GeraciGregory/HypnosiaController/Documentation/Report/HYPNOSIA_Controller_Summary.pdf

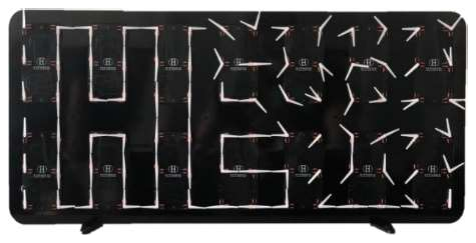
[picture p11: figure]
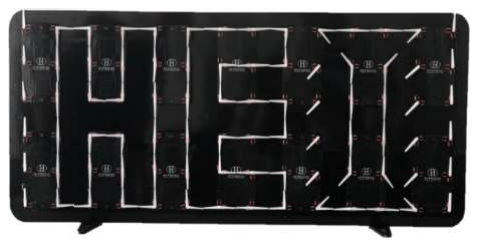
[picture p12: figure]

| 2 0 2 0 |

Degree programme
Industrial Systems

Field of application
Infotronics

Supervising professor
Dr Silvan Zahno
silvan.zahno@hevs.ch

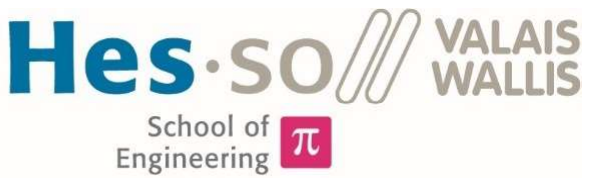
[picture p13: figure]

## Objectives

The project consists in developing and implementing a prototype of a bi-axes movements matrix display that allows the creation of the most hypnotizing animations.

## Methods | Experiences | Results

The matrix display consists of 84 bi-axes movements produced by SOPROD SA. The ultimate goal is to control animations via Bluetooth according to the user's wishes.

The system is composed of a MASTER (Raspberry Pi), a GATEWAY (processor) and 13 SLAVES (processor). The system works as follows: the Raspberry Pi (MASTER) manages the Bluetooth connection and transmits the data required to control the movement matrix to the processor (GATEWAY) via SPI. This processor then processes the data received via SPI and transmits the data to all other processors (SLAVES) via a CAN bus. Each processor controls 6 bi-axes movements.

The first prototype developed gives conclusive results.

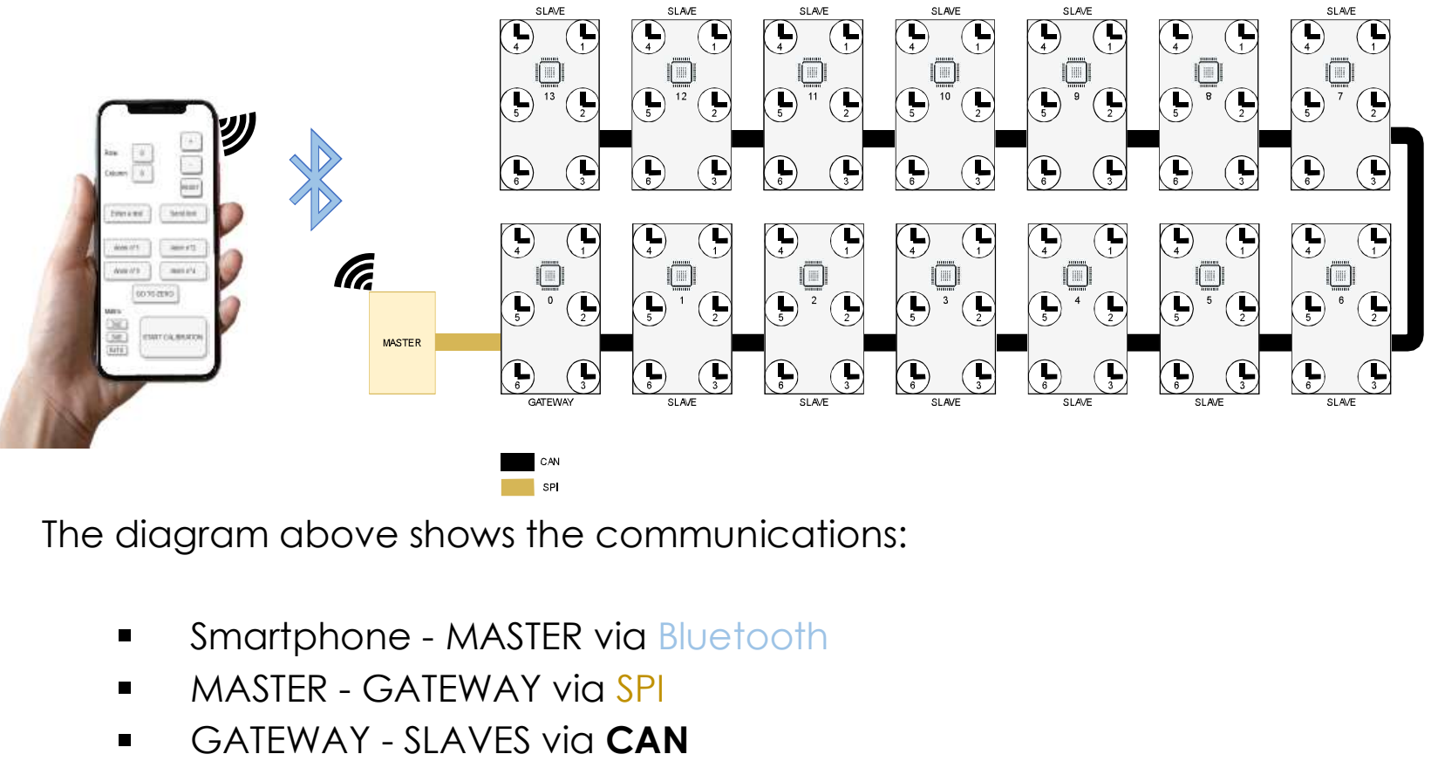
[picture p14: figure]
Smartphone - MASTER via Bluetooth MASTER - GATEWAY via SPI GATEWAY - SLAVES via CAN

The diagram above shows the communications:

# HYPNOSIA Controller

Graduate | Gregory Geraci
