GeraciGregory/HypnosiaController/HYPNOSIA_Altium/HYPNOSIA_V1_CAN/hypnosia_top_v1_180620.PNG

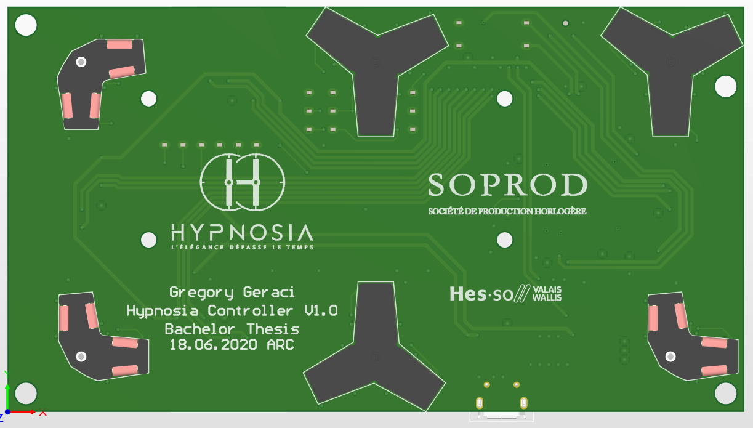
HYPNOSIA_Altium/HYPNOSIA_V1_CAN/hypnosia_top_v1_180620.PNG
