GeraciGregory/HypnosiaController/Documentation/HYPNOSIA_Prices_Chart.xlsx

Prices
Material | Price / 1 unit | Price / 10 units | Price / 100 units | Price / 1000 units | Price / 5000 units | Manufacturer | Currency
Movment | 7 | 6 | 5 | 4 | 3 | SOPROD SA | CHF
Raspberry Pi Zero | 20 | 19 | 18 | 17 | 15 | / | CHF
Microcontroller ARM STM32F072V8T6 | 3.82 | 3.24 | 2.81 | 2.01 | 1.88 | Mouser | CHF
Molex 5 pin SMD male | 2.61 | 2.36 | 2.06 | 1.37 | 1.27 | Mouser | CHF
Molex 5 pin SMD female | 0.458 | 0.358 | 0.31 | 0.248 | 0.2 | Mouser | CHF
MICRO USB B Connector | 0.706 | 0.537 | 0.47 | 0.369 | 0.3 | Mouser | CHF
LDO voltage converter | 0.82 | 0.7 | 0.474 | 0.349 | 0.33 | Mouser | CHF
CAN converter MCP2542 | 0.735 | 0.611 | 0.563 | 0.48 | 0.41 | Mouser | CHF
Pin Header 2x20 SMD | 4.05 | 3.88 | 3.24 | 2.34 | 2.11 | Mouser | CHF
Quartz 16MHz | 0.515 | 0.429 | 0.343 | 0.275 | 0.248 | Mouser | CHF
PCB 2x3 (58mm x 106mm) | 19.8 | 10.5 | 2.04 | 0.945 | 0.764 | PCBWay | US $
PCB 3x8 (106mm x 346mm) | 29.4 | 18.2 | 7.01 | 4.56 | 4.522 | PCBWay | US $
PCB 6x14 (250mm x 634mm) | 87.6 | 60.8 | 31.01 | 28.811 | 28.63 | PCBWay | US $
Box | 30 | 25 | 20 | 10 | 7 | / | CHF
Watch pointers | 0.5 | 0.45 | 0.3 | 0.15 | 0.05 | / | CHF
3x8 model with 2x3 PCB |  |  |  |  |  |  |  |  | 6x14 model with 2x3 PCB
Need | Quantity for one model | Price / 1 unit | Price / 10 unit | Price / 100 unit | Price / 1000 unit | Price / 5000 unit |  |  | Need | Quantity for one model | Price / 1 unit | Price / 10 unit | Price / 100 unit | Price / 1000 unit | Price / 5000 unit
Movment | 24 | 168 | 144 | 120 | 96 | 72 |  |  | Movment | 88 | 616 | 528 | 440 | 352 | 264
Raspberry Pi Zero | 1 | 20 | 19 | 18 | 17 | 15 |  |  | Raspberry Pi Zero | 1 | 20 | 19 | 18 | 17 | 15
Microcontroller ARM STM32F072V8T6 | 4 | 15.28 | 12.96 | 11.24 | 8.04 | 7.52 |  |  | Microcontroller ARM STM32F072V8T6 | 14 | 53.48 | 45.36 | 39.34 | 28.14 | 26.32
Molex 5 pin SMD male | 6 | 15.66 | 14.16 | 12.36 | 8.22 | 7.62 |  |  | Molex 5 pin SMD male | 26 | 67.86 | 61.36 | 53.56 | 35.62 | 33.02
Molex 5 pin SMD female | 6 | 2.748 | 2.148 | 1.86 | 1.488 | 1.2 |  |  | Molex 5 pin SMD female | 26 | 11.908 | 9.308 | 8.06 | 6.448 | 5.2
CAN converter MCP2542 | 4 | 2.94 | 2.444 | 2.252 | 1.92 | 1.64 |  |  | CAN converter MCP2542 | 14 | 10.29 | 8.554 | 7.882 | 6.72 | 5.74
Pin Header 2x20 SMD | 1 | 4.05 | 3.88 | 3.24 | 2.34 | 2.11 |  |  | Pin Header 2x20 SMD | 1 | 4.05 | 3.88 | 3.24 | 2.34 | 2.11
Quartz 16MHz | 4 | 2.06 | 1.716 | 1.372 | 1.1 | 0.992 |  |  | Quartz 16MHz | 14 | 7.21 | 6.006 | 4.802 | 3.85 | 3.472
Box | 1 | 30 | 25 | 20 | 10 | 7 |  |  | Box | 1 | 30 | 25 | 20 | 10 | 7
Watch pointers | 48 | 24 | 21.6 | 14.4 | 7.2 | 2.4 |  |  | Watch pointers | 168 | 84 | 75.6 | 50.4 | 25.2 | 8.4
PCB 2x3 | 4 | 79.2 | 42 | 8.16 | 3.78 | 3.056 |  |  | PCB 2x3 | 14 | 277.2 | 147 | 28.56 | 13.23 | 10.696
 | Total | 363.938 | 288.908 | 212.884 | 157.088 | 120.538 |  |  |  | Total | 1181.998 | 929.068 | 673.844 | 500.548 | 380.958
3x8 model with 3x8 PCB |  |  |  |  |  |  |  |  | 6x14 model with 6x14 PCB
Need | Quantity for one model | Price / 1 unit | Price / 10 unit | Price / 100 unit | Price / 1000 unit | Price / 5000 unit |  |  | Need | Quantity for one model | Price / 1 unit | Price / 10 unit | Price / 100 unit | Price / 1000 unit | Price / 5000 unit
Movment | 24 | 168 | 144 | 120 | 96 | 72 |  |  | Movment | 88 | 616 | 528 | 440 | 352 | 264
Raspberry Pi Zero | 1 | 20 | 19 | 18 | 17 | 15 |  |  | Raspberry Pi Zero | 1 | 20 | 19 | 18 | 17 | 15
Microcontroller ARM STM32F072V8T6 | 4 | 15.28 | 12.96 | 11.24 | 8.04 | 7.52 |  |  | Microcontroller ARM STM32F072V8T6 | 14 | 53.48 | 45.36 | 39.34 | 28.14 | 26.32
CAN converter MCP2542 | 4 | 2.94 | 2.444 | 2.252 | 1.92 | 1.64 |  |  | CAN converter MCP2542 | 14 | 10.29 | 8.554 | 7.882 | 6.72 | 5.74
Pin Header 2x20 SMD | 1 | 4.05 | 3.88 | 3.24 | 2.34 | 2.11 |  |  | Pin Header 2x20 SMD | 1 | 4.05 | 3.88 | 3.24 | 2.34 | 2.11
Quartz 16MHz | 4 | 2.06 | 1.716 | 1.372 | 1.1 | 0.992 |  |  | Quartz 16MHz | 14 | 7.21 | 6.006 | 4.802 | 3.85 | 3.472
Box | 1 | 30 | 25 | 20 | 10 | 7 |  |  | Box | 1 | 30 | 25 | 20 | 10 | 7
Watch pointers | 48 | 24 | 21.6 | 14.4 | 7.2 | 2.4 |  |  | Watch pointers | 168 | 84 | 75.6 | 50.4 | 25.2 | 8.4
PCB 3x8 | 1 | 29.4 | 18.2 | 7.01 | 4.56 | 4.522 |  |  | PCB 6x14 | 1 | 29.4 | 18.2 | 7.01 | 4.56 | 4.522
 | Total | 295.73 | 248.8 | 197.514 | 148.16 | 113.184 |  |  |  | Total | 854.43 | 729.6 | 590.674 | 449.81 | 336.564
Savec money for all products cost [CHF] |  | 68.208 | 401.08 | 1537 | 8928 | 36770 |  |  | Savec money for all products cost [CHF] |  | 327.568 | 1994.68 | 8317 | 50738 | 221970
 |  |  |  |  |  |  |  | 1
 |  |  |  |  |  |  |  | 10
 |  |  |  |  |  |  |  | 100
 |  |  |  |  |  |  |  | 1000
 |  |  |  |  |  |  |  | 5000
