GeraciGregory/HypnosiaController/HYPNOSIA_Inventor/front_Box.dxf

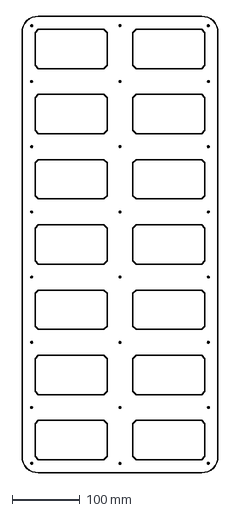
[picture p17: CAD file, 2020-07-16]
HYPNOSIA_Inventor/front_Box.dxf
288.0 x 672.0 mm
