GeraciGregory/HypnosiaController/HYPNOSIA_Inventor/back_Box.dxf

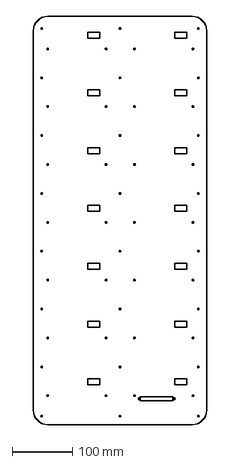
[picture p18: CAD file, 2020-07-16]
HYPNOSIA_Inventor/back_Box.dxf
288.0 x 678.0 mm
