GeraciGregory/HypnosiaController/HYPNOSIA_Inventor/HYPNOSIA_controller_V2.step

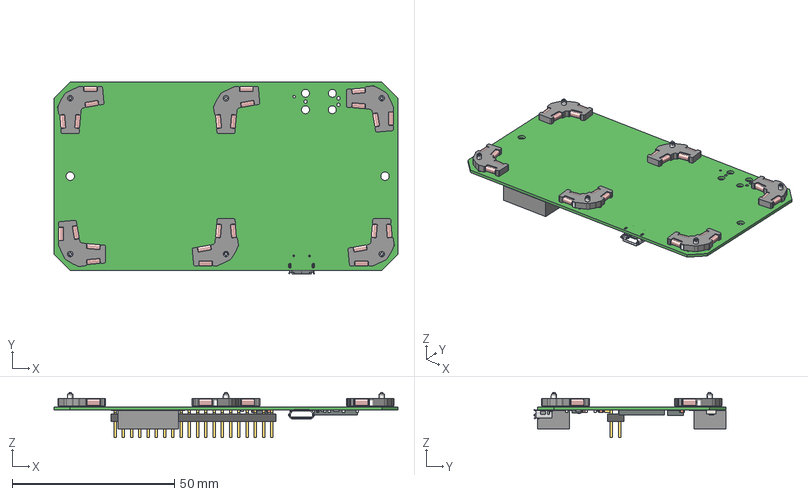
[picture p19: CAD file, 2020-07-08]
HYPNOSIA_Inventor/HYPNOSIA_controller_V2.step
106.0 x 59.2 x 13.9 mm
GB2M x 6
Extruded x 156
User_Library-RESC1608X05N x 2
ZX62D-B-5PA8
Pins x 2
