GeraciGregory/HypnosiaController/(list of files, cad)

Other CAD files:
HYPNOSIA_Inventor/HYPNOSIA_6x14.iam
HYPNOSIA_Inventor/OldVersions/HYPNOSIA_6x14.0009.iam
HYPNOSIA_Inventor/OldVersions/back_Box.0016.ipt
HYPNOSIA_Inventor/OldVersions/front_Box.0012.ipt
HYPNOSIA_Inventor/OldVersions/support.0007.ipt
HYPNOSIA_Inventor/back_Box.ipt
HYPNOSIA_Inventor/front_Box.ipt
HYPNOSIA_Inventor/support.ipt
