GeraciGregory/HypnosiaController/(threads)

Thread 1 (2020-05-29):

v1.0 Schematic Questions/Remarks

tschinz, 2020-05-29:
1. No i2C on STM32 Proc
2. Add notes for resistor placement
3. Properly naming of Pins for the watches
4. Select led and calulate current and resistor
5. Does boot pin need to be exposed?
6. Where goes the TSW0 Signal
7. No external Oscillator needed?
8. Set DNF (Do not Fit) on optional Resistors
9. Powerdelivery only by RPI Header? Can it deliver enough power?
10. Needs optional external Powersupply in case RPI is not mounted (USB Power connector with [5V to 3.3V LDO](https://ch.farnell.com/w/c/halbleiter-ics/power-management-ics-pmic-/spannungsregler/ldo-spannungsregler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)

Closed 2020-06-21.
