GeraciGregory/HypnosiaController/Documentation/Altium/HYPNOSIA_controller_V2.pdf

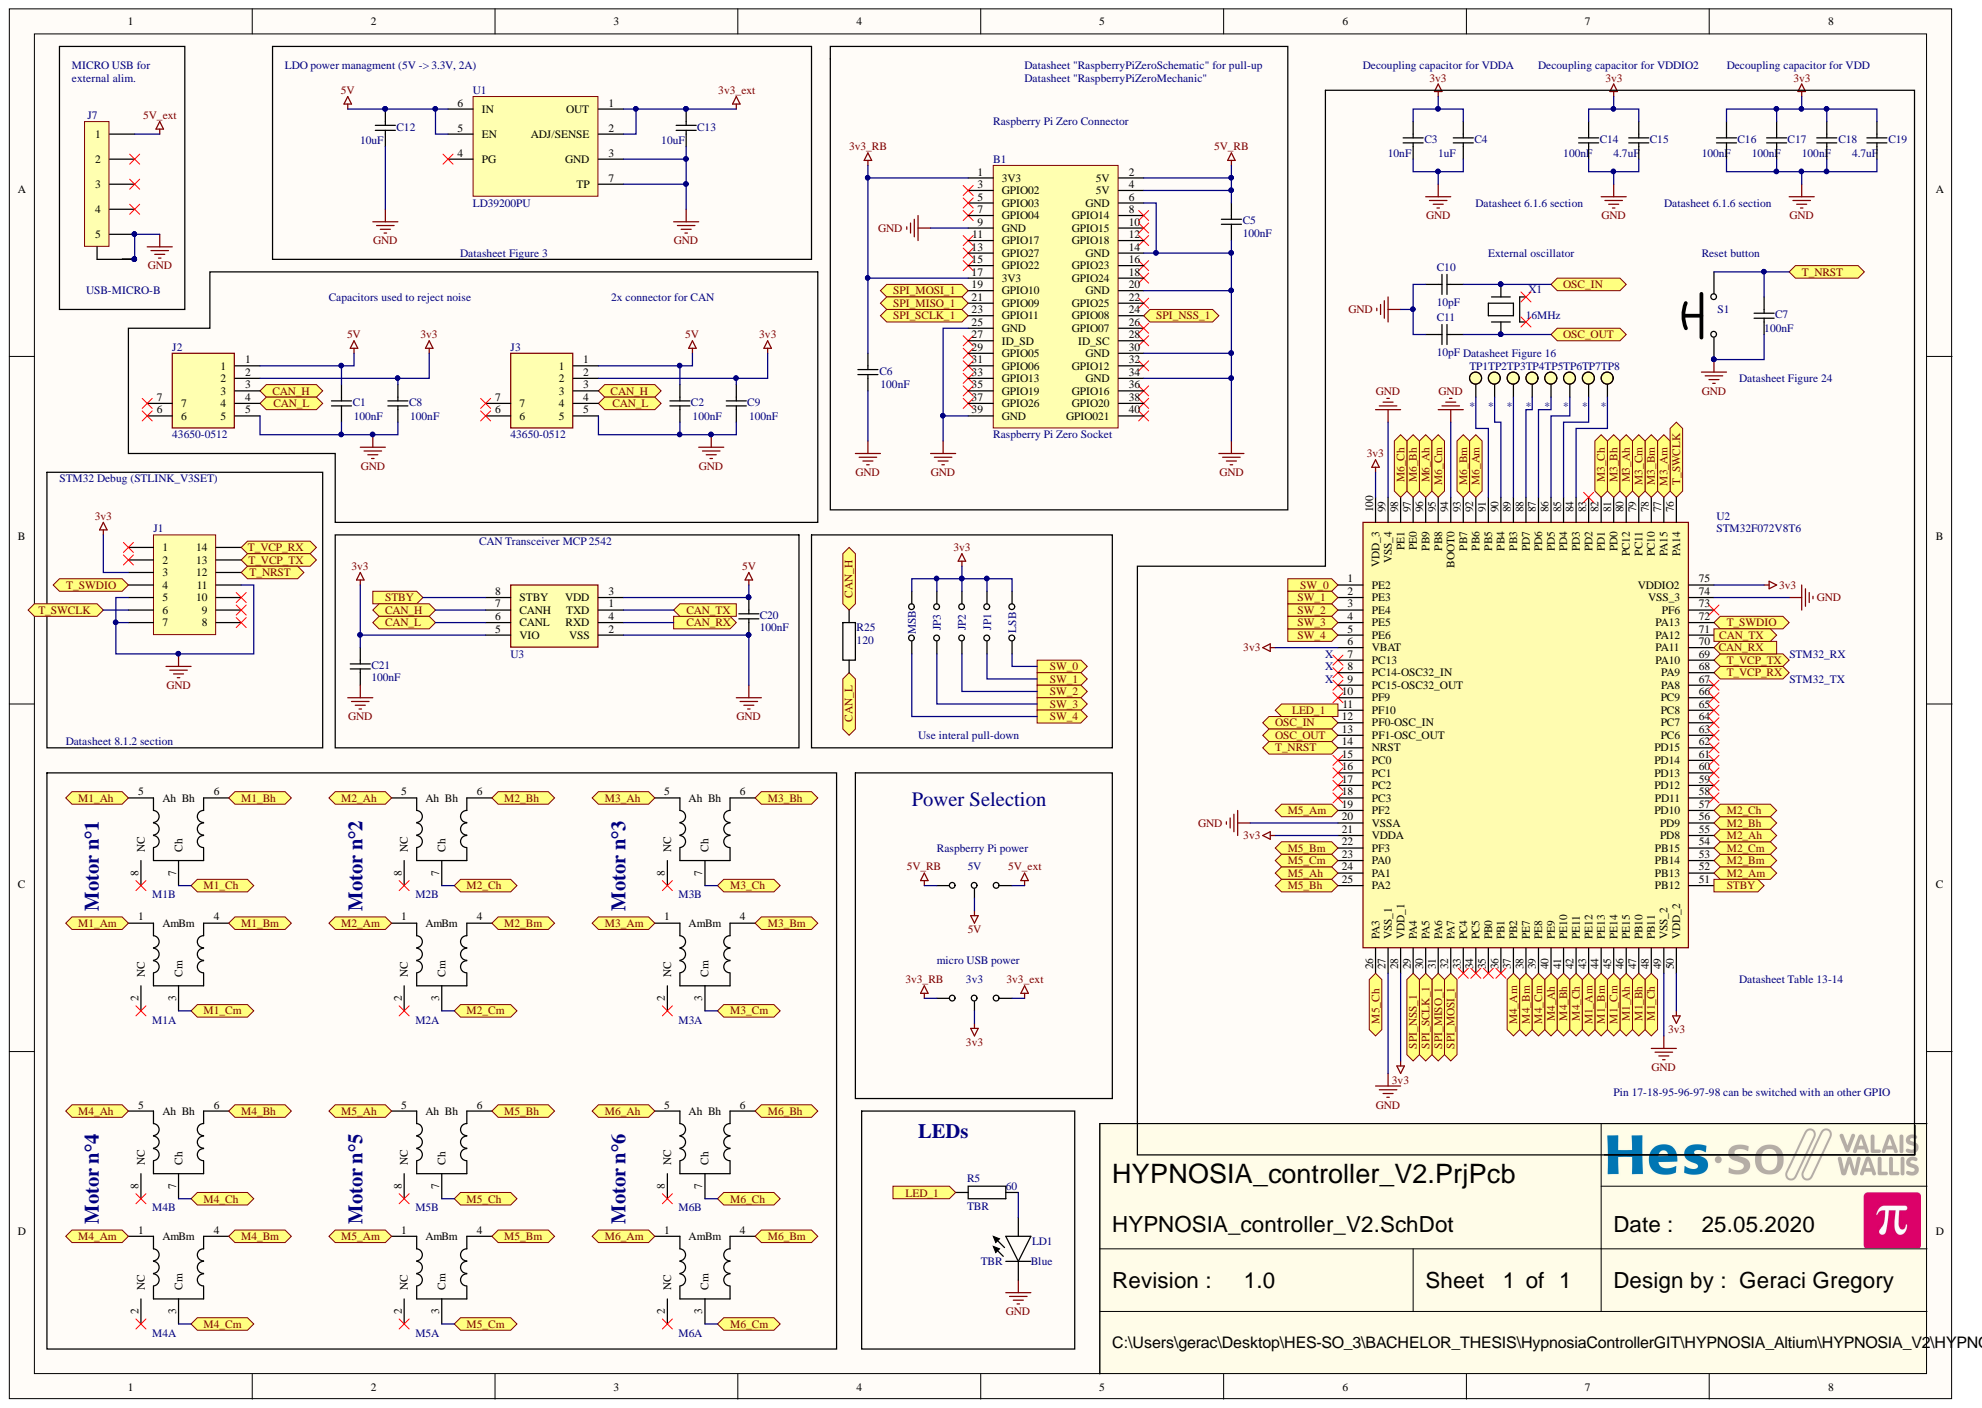
[picture p20: page 1]

Datasheet "RaspberryPiZeroSchematic" for pull-up
Datasheet "RaspberryPiZeroMechanic"

Decoupling capacitor for VDD

Raspberry Pi Zero Connector

Capacitors used to reject noise

Raspberry Pi Zero Socket

Use interal pull-down

Pin 17-18-95-96-97-98 can be switched with an other GPIO

C:\Users\gerac\Desktop\HES-SO_3\BACHELOR_THESIS\HypnosiaControllerGIT\HYPNOSIA_Altium\HYPNOSIA_V2\HYPNOSIA_V2\HYPNOSIA_controller_V2.SchDot

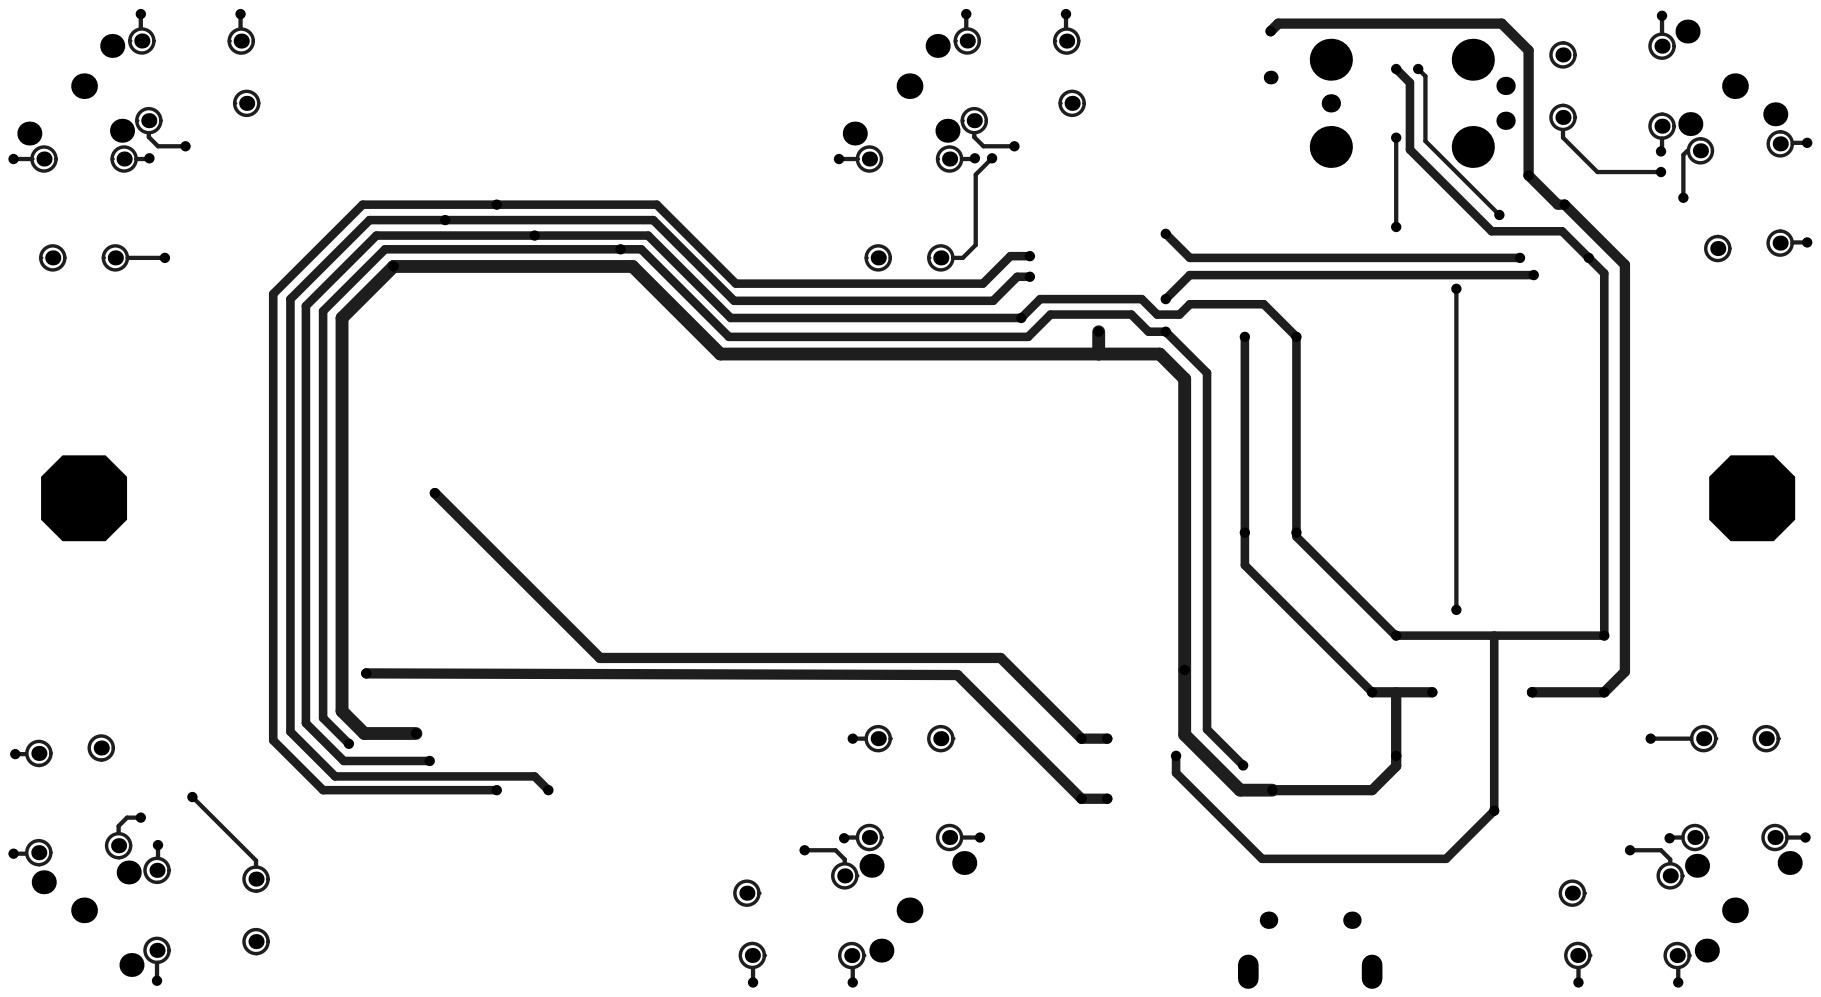
[picture p21: page 2]

# Board Stack Report
