GeraciGregory/HypnosiaController/Documentation/Altium/HYPNOSIA_controller_V1_CAN.pdf

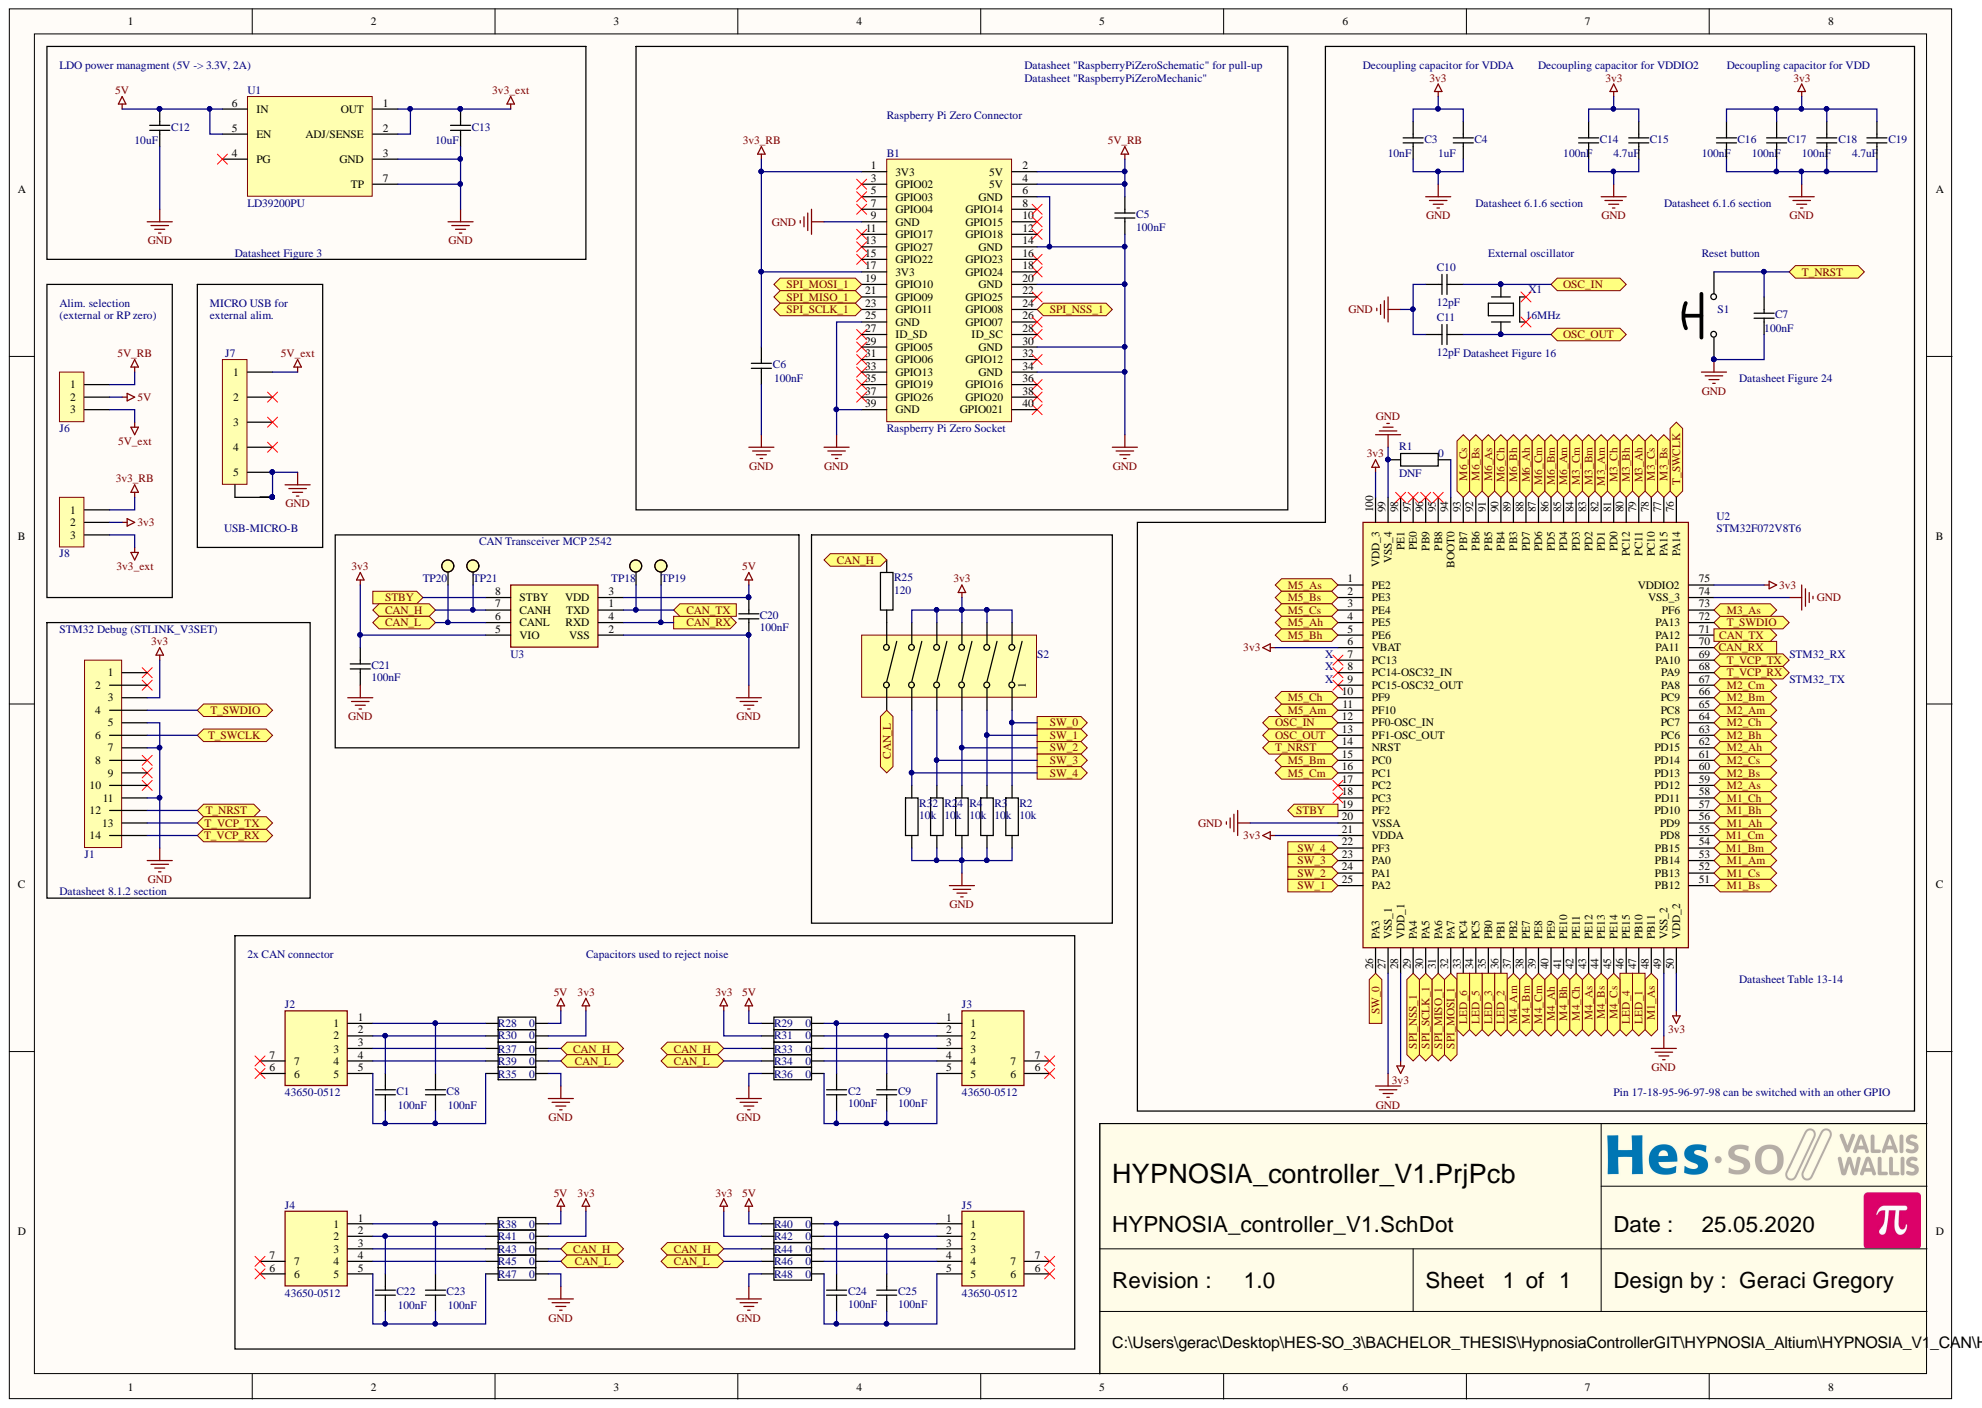
[picture p22: page 1]

Datasheet "RaspberryPiZeroSchematic" for pull-up
Datasheet "RaspberryPiZeroMechanic"

Decoupling capacitor for VDD

Raspberry Pi Zero Connector

Alim. selection
(external or RP zero)

Raspberry Pi Zero Socket

Capacitors used to reject noise

Pin 17-18-95-96-97-98 can be switched with an other GPIO

HYPNOSIA_controller_V1.PrjPcb HYPNOSIA_controller_V1.SchDot

C:\Users\gerac\Desktop\HES-SO_3\BACHELOR_THESIS\HypnosiaControllerGIT\HYPNOSIA_Altium\HYPNOSIA_V1_CAN\HYPNOSIA_controller_V1.SchDot

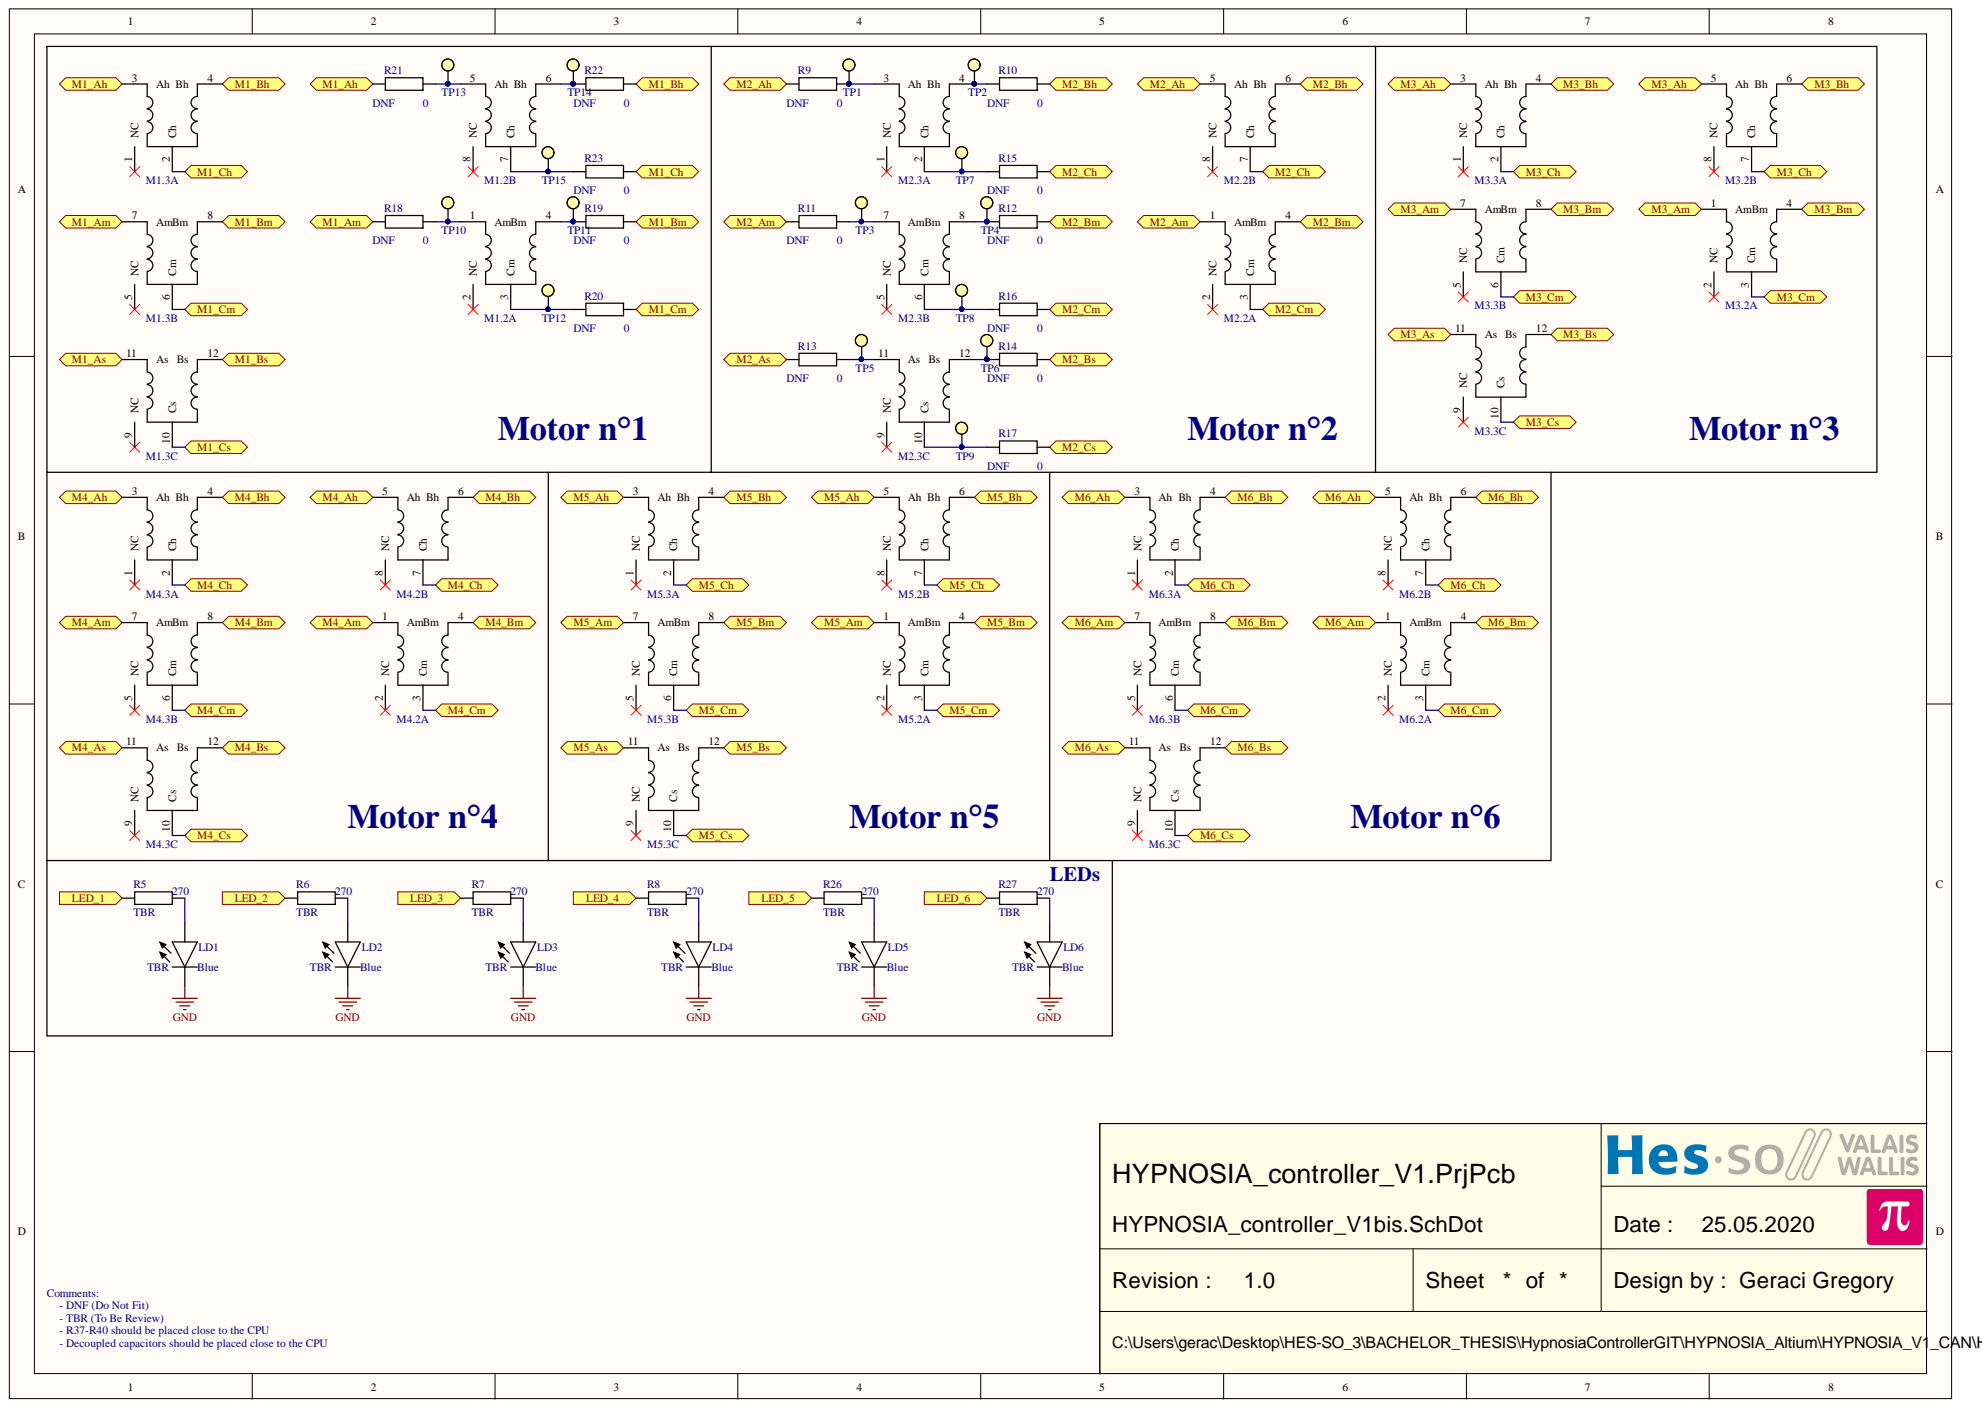
[picture p23: page 2]

HYPNOSIA_controller_V1.PrjPcb HYPNOSIA_controller_V1bis.SchDot

Revision : 1.0 | Sheet * of * | Design by : Geraci Gregory

Comments:
- DNF (Do Not Fit)
- TBR (To Be Review)
- R37-R40 should be placed close to the CPU
- Decoupled capacitors should be placed close to the CPU

C:\Users\gerac\Desktop\HES-SO_3\BACHELOR_THESIS\HypnosiaControllerGIT\HYPNOSIA_Altium\HYPNOSIA_V1_CAN\HYPNOSIA_controller_V1bis.SchDot

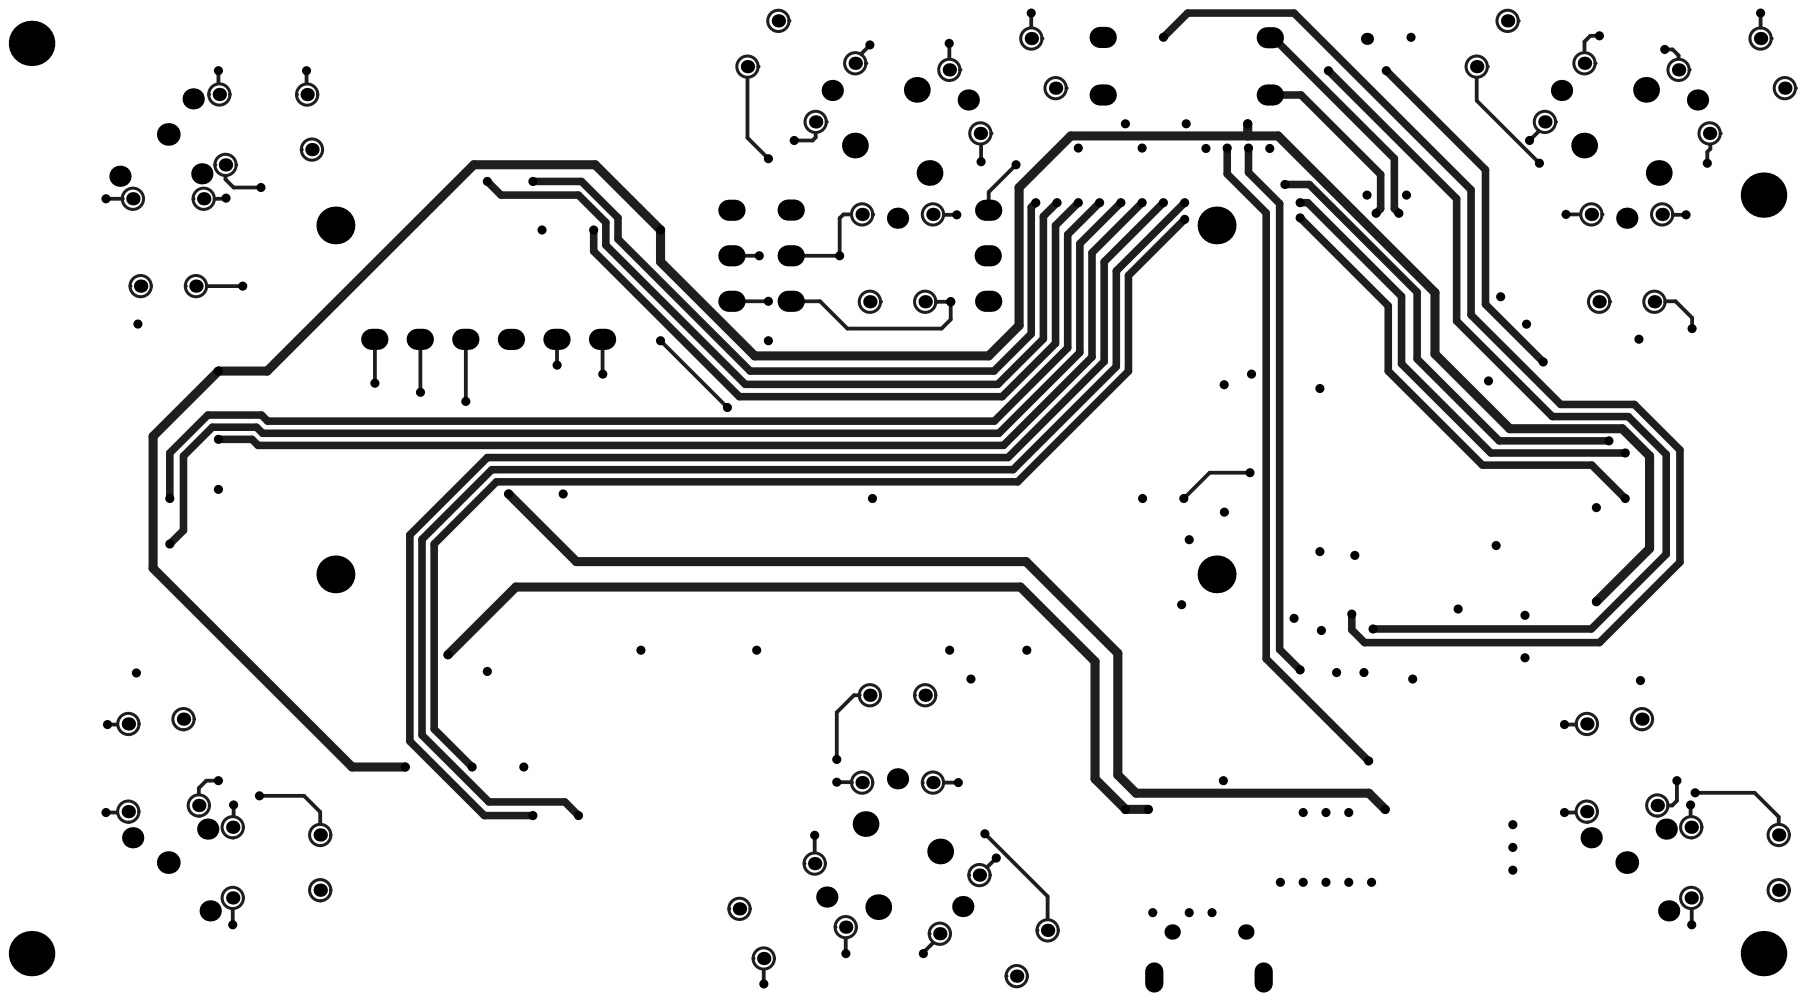
[picture p24: page 3]

# Board Stack Report
