GeraciGregory/HypnosiaController/Documentation/Diagrams/RPI_diagrams.pdf

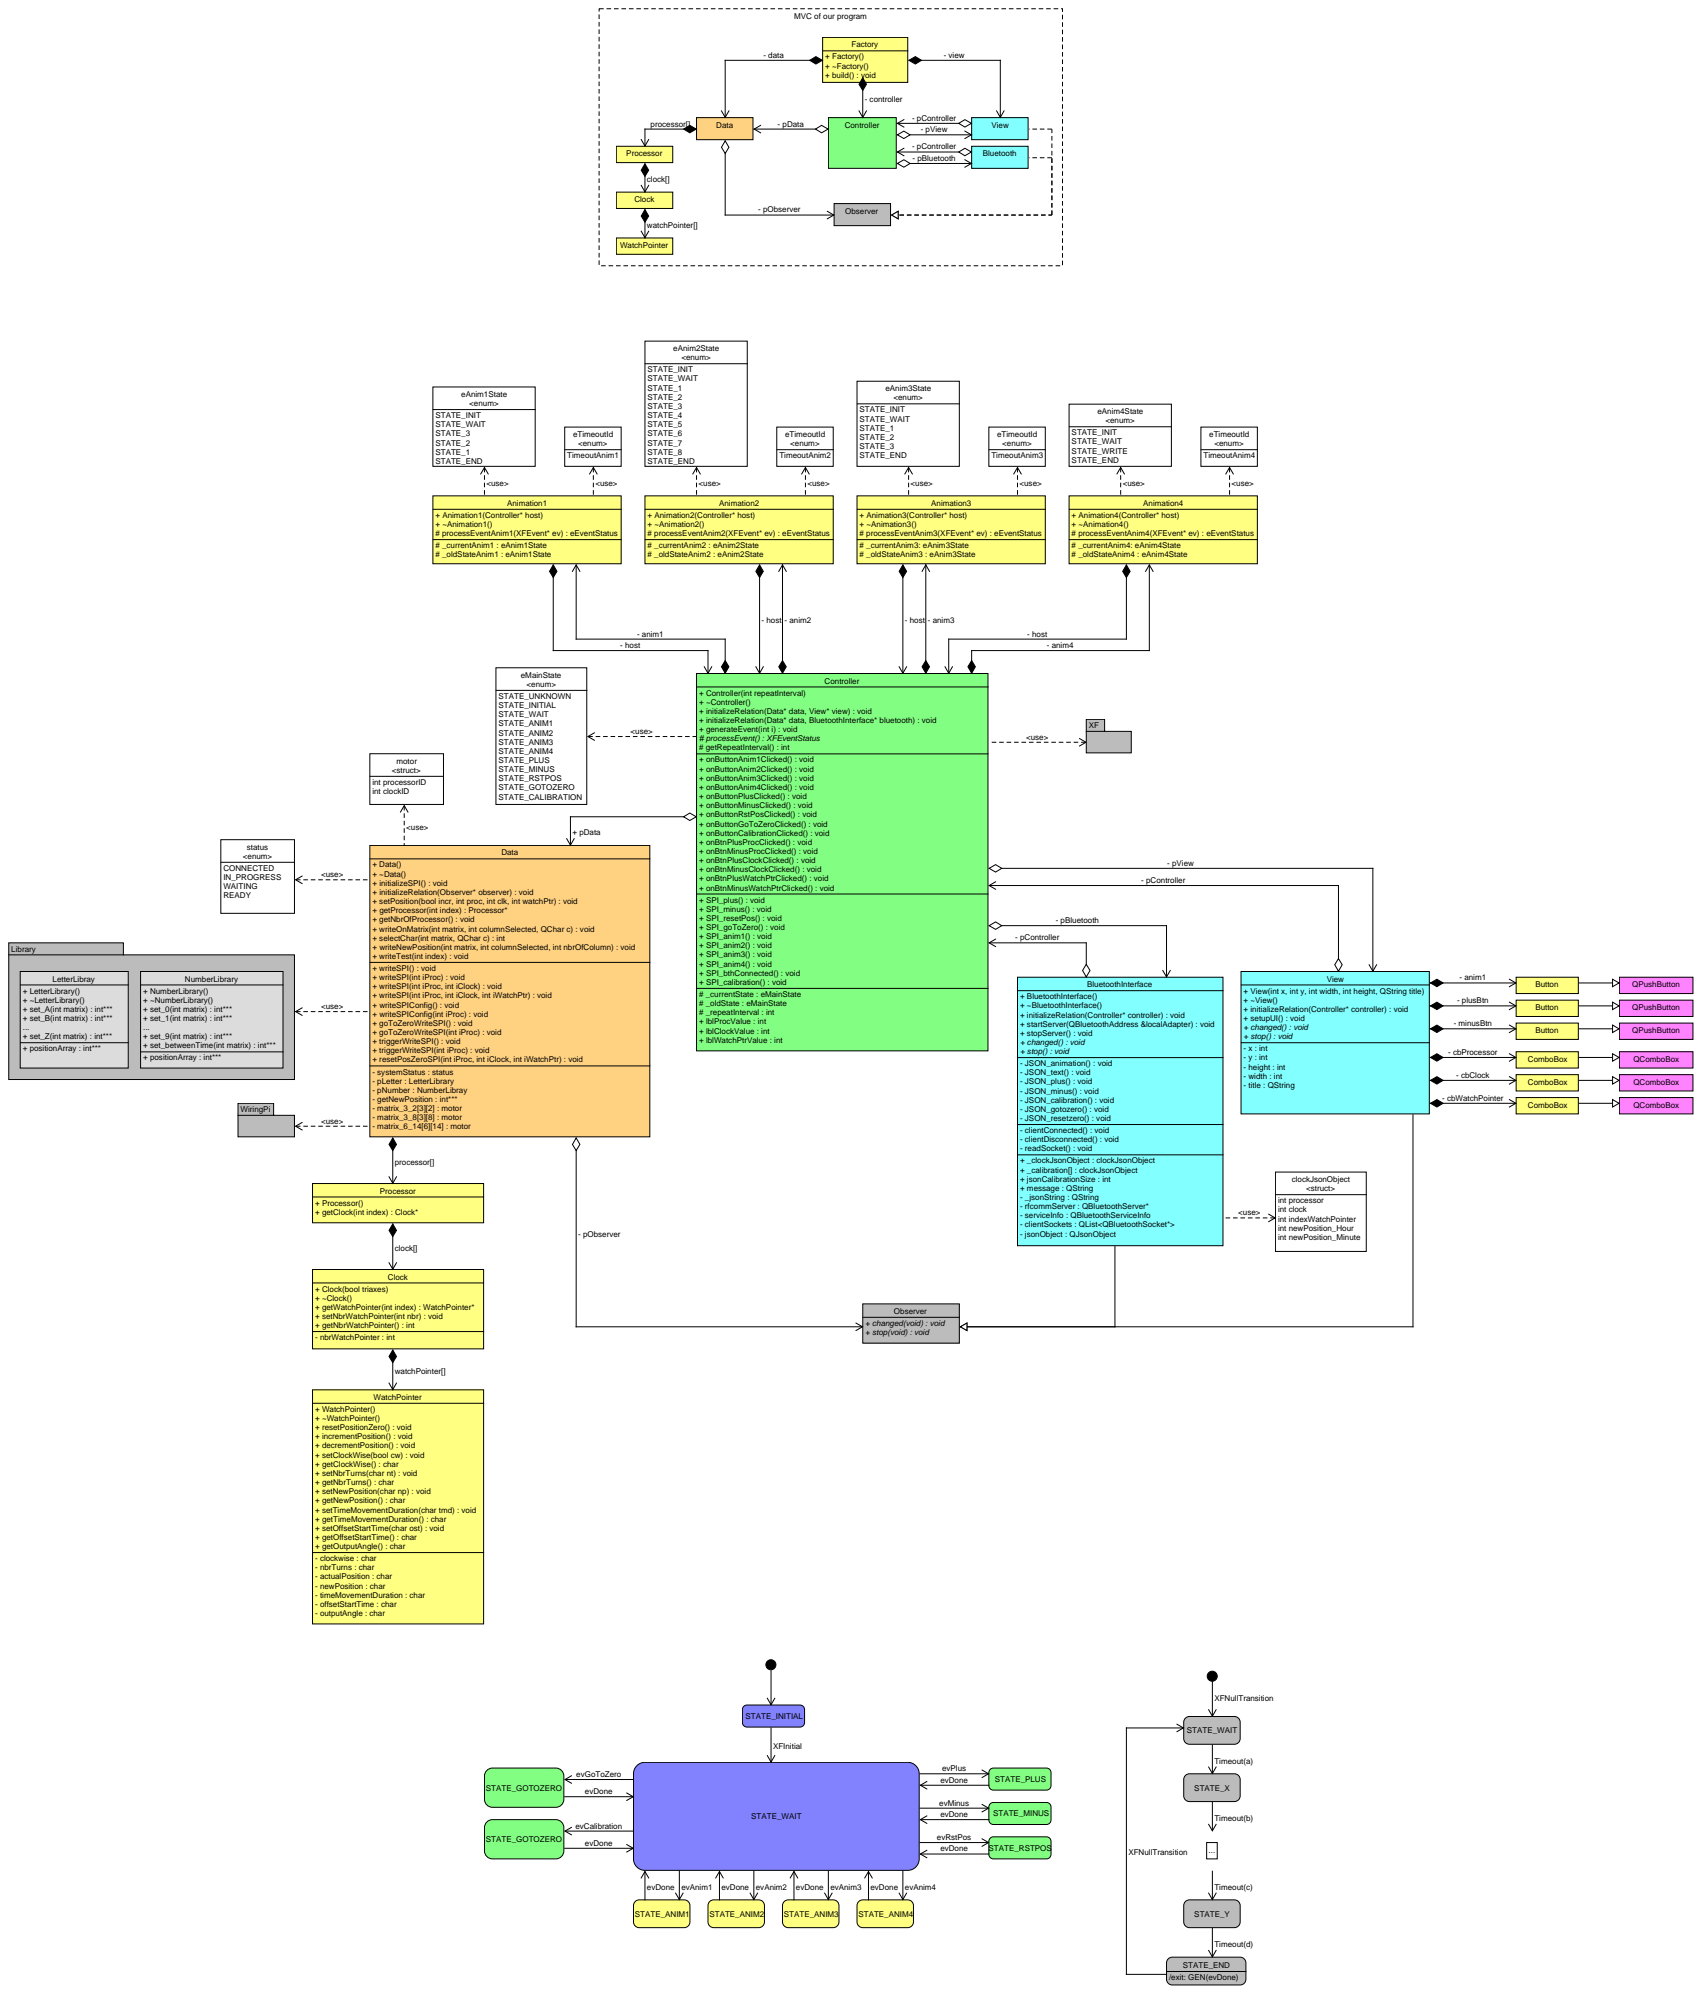
[picture p25: page 1]
Library; STATE_Y; STATE_X; STATE_WAIT; NumberLibrary; LetterLibray; WiringPi; motor <struct> int processorID int clockID; eTimeoutId <enum> TimeoutAnim4; eAnim4State <enum> STATE_INIT STATE_WAIT STATE_WRITE STATE_END; Animation4 + Animation4(Controller* host) + ~Animation4() # processEventAnim4(XFEvent* ev) : eEventStatus # _currentAnim4: eAnim4State # _oldStateAnim4 : eAnim4State; eTimeoutId <enum> TimeoutAnim3; eAnim3State <enum> STATE_INIT STATE_WAIT STATE_1 STATE_2 STATE_3 STATE_END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

MVC of our program

+ Controller(int repeatInterval)
+ ~Controller()
+ initializeRelation(Data* data, View* view) : void
+ initializeRelation(Data* data, BluetoothInterface* bluetooth) : void
+ generateEvent(int i) : void
# processEvent() : XFEventStatus
# getRepeatInterval() : int
+ onButtonAnim1Clicked() : void
+ onButtonAnim2Clicked() : void
+ onButtonAnim3Clicked() : void
+ onButtonAnim4Clicked() : void
+ onButtonPlusClicked() : void
+ onButtonMinusClicked() : void
+ onButtonRstPosClicked() : void
+ onButtonGoToZeroClicked() : void
+ onButtonCalibrationClicked() : void
+ onBtnPlusProcClicked() : void
+ onBtnMinusProcClicked() : void
+ onBtnPlusClockClicked() : void
+ onBtnMinusClockClicked() : void
+ onBtnPlusWatchPtrClicked() : void
+ onBtnMinusWatchPtrClicked() : void
+ SPI_plus() : void
+ SPI_minus() : void
+ SPI_resetPos() : void
+ SPI_goToZero() : void
+ SPI_anim1() : void
+ SPI_anim2() : void
+ SPI_anim3() : void
+ SPI_anim4() : void
+ SPI_bthConnected() : void
+ SPI_calibration() : void
# _currentState : eMainState
# _oldState : eMainState
# _repeatInterval : int
+ lblProcValue : int
+ lblClockValue : int
+ lblWatchPtrValue : int

+ Data()
+ ~Data()
+ initializeSPI() : void
+ initializeRelation(Observer* observer) : void
+ setPosition(bool incr, int proc, int clk, int watchPtr) : void
+ getProcessor(int index) : Processor*
+ getNbrOfProcessor() : void
+ writeOnMatrix(int matrix, int columnSelected, QChar c) : void
+ selectChar(int matrix, QChar c) : int
+ writeNewPosition(int matrix, int columnSelected, int nbrOfColumn) : void
+ writeTest(int index) : void
+ writeSPI() : void
+ writeSPI(int iProc) : void
+ writeSPI(int iProc, int iClock) : void
+ writeSPI(int iProc, int iClock, int iWatchPtr) : void
+ writeSPIConfig() : void
+ writeSPIConfig(int iProc) : void
+ goToZeroWriteSPI() : void
+ goToZeroWriteSPI(int iProc) : void
+ triggerWriteSPI() : void
+ triggerWriteSPI(int iProc) : void
+ resetPosZeroSPI(int iProc, int iClock, int iWatchPtr) : void
- systemStatus : status
- pLetter : LetterLibrary
- pNumber : NumberLibray
- getNewPosition : int***
- matrix_3_2[3][2] : motor
- matrix_3_8[3][8] : motor
- matrix_6_14[6][14] : motor

+ LetterLibrary()
+ ~LetterLibrary()
+ set_A(int matrix) : int***
+ set_B(int matrix) : int***
+ set_Z(int matrix) : int***
+ positionArray : int***

+ NumberLibrary()
+ ~NumberLibrary()
+ set_0(int matrix) : int***
+ set_1(int matrix) : int***
+ set_9(int matrix) : int***
+ set_betweenTime(int matrix) : int***

+ View(int x, int y, int width, int height, QString title)
+ ~View()
+ initializeRelation(Controller* controller) : void
+ setupUI() : void
+ changed() : void
+ stop() : void
- x : int
- y : int
- height : int
- width : int
- title : QString

+ BluetoothInterface()
+ ~BluetoothInterface()
+ startServer(QBluetoothAddress &localAdapter) : void
+ stopServer() : void
- JSON_animation() : void
- JSON_text() : void
- JSON_plus() : void
- JSON_minus() : void
- JSON_calibration() : void
- JSON_gotozero() : void
- JSON_resetzero() : void
- clientConnected() : void
- clientDisconnected() : void
- readSocket() : void
+ _clockJsonObject : clockJsonObject
+ _calibration[] : clockJsonObject
+ jsonCalibrationSize : int
+ message : QString
- _jsonString : QString
- rfcommServer : QBluetoothServer*
- serviceInfo : QBluetoothServiceInfo
- clientSockets : QList<QBluetoothSocket*>
- jsonObject : QJsonObject

+ Processor()
+ getClock(int index) : Clock*

+ Clock(bool triaxes)
+ ~Clock()
+ getWatchPointer(int index) : WatchPointer*
+ setNbrWatchPointer(int nbr) : void
+ getNbrWatchPointer() : int
- nbrWatchPointer : int

+ changed(void) : void
+ stop(void) : void

+ WatchPointer()
+ ~WatchPointer()
+ resetPositionZero() : void
+ incrementPosition() : void
+ decrementPosition() : void
+ setClockWise(bool cw) : void
+ getClockWise() : char
+ setNbrTurns(char nt) : void
+ getNbrTurns() : char
+ setNewPosition(char np) : void
+ getNewPosition() : char
+ setTimeMovementDuration(char tmd) : void
+ getTimeMovementDuration() : char
+ setOffsetStartTime(char ost) : void
+ getOffsetStartTime() : char
+ getOutputAngle() : char
- clockwise : char
- nbrTurns : char
- actualPosition : char
- newPosition : char
- timeMovementDuration : char
- offsetStartTime : char
- outputAngle : char

STATE_END
/exit: GEN(evDone)
