GeraciGregory/HypnosiaController/Documentation/Diagrams/STM32_diagrams.pdf

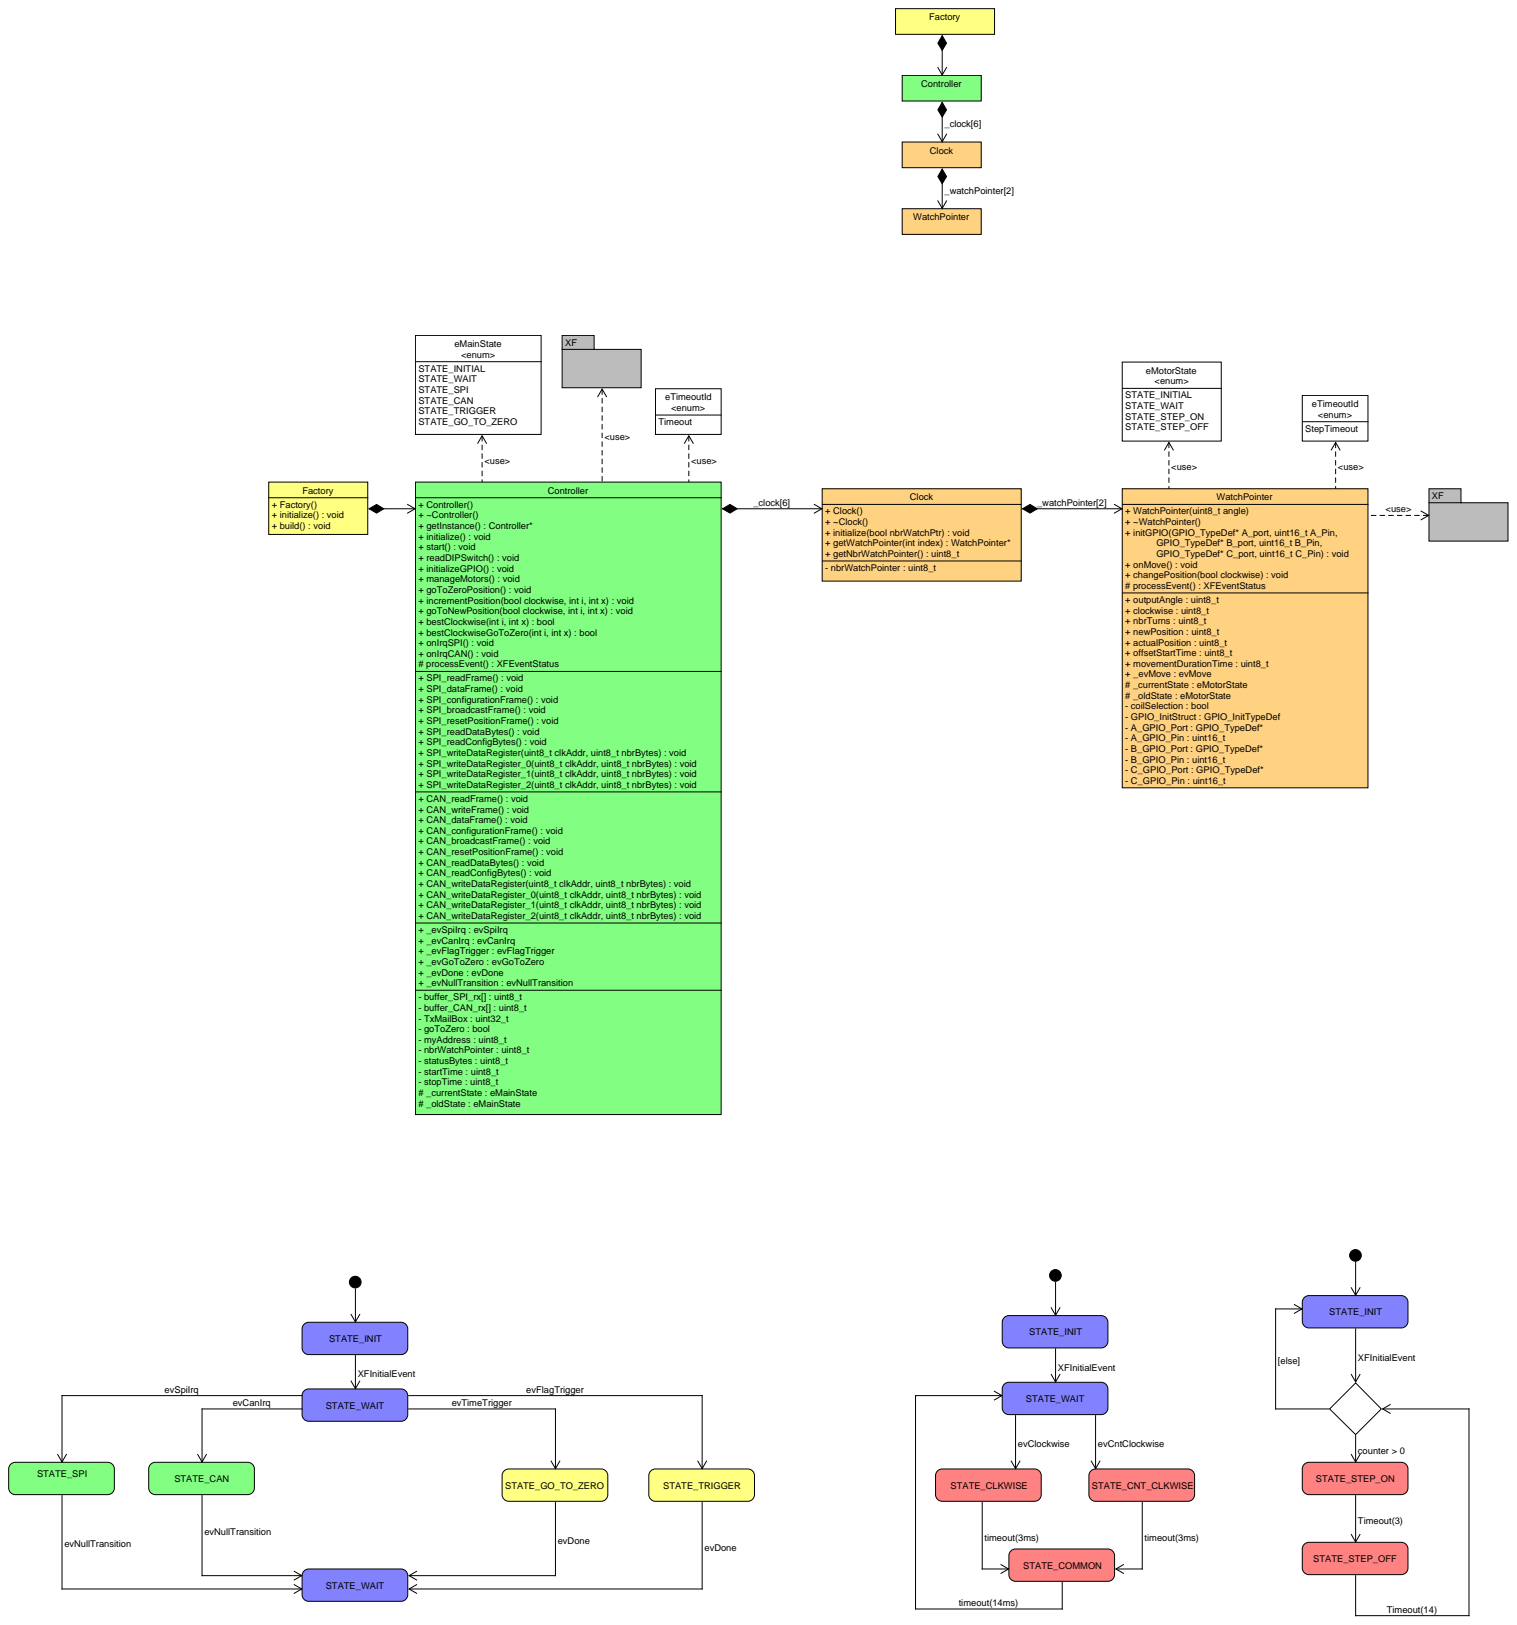
[picture p26: page 1]
Factory + Factory() + initialize() : void + build() : void; eTimeoutId <enum> Timeout; eMainState <enum> STATE_INITIAL STATE_WAIT STATE_SPI STATE_CAN STATE_TRIGGER STATE_GO_TO_ZERO; Controller; Clock; eTimeoutId <enum> StepTimeout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

+ Controller()
+ ~Controller()
+ getInstance() : Controller*
+ initialize() : void
+ start() : void
+ readDIPSwitch() : void
+ initializeGPIO() : void
+ manageMotors() : void
+ goToZeroPosition() : void
+ incrementPosition(bool clockwise, int i, int x) : void
+ goToNewPosition(bool clockwise, int i, int x) : void
+ bestClockwise(int i, int x) : bool
+ bestClockwiseGoToZero(int i, int x) : bool
+ onIrqSPI() : void
+ onIrqCAN() : void
# processEvent() : XFEventStatus
+ SPI_readFrame() : void
+ SPI_dataFrame() : void
+ SPI_configurationFrame() : void
+ SPI_broadcastFrame() : void
+ SPI_resetPositionFrame() : void
+ SPI_readDataBytes() : void
+ SPI_readConfigBytes() : void
+ SPI_writeDataRegister(uint8_t clkAddr, uint8_t nbrBytes) : void
+ SPI_writeDataRegister_0(uint8_t clkAddr, uint8_t nbrBytes) : void
+ SPI_writeDataRegister_1(uint8_t clkAddr, uint8_t nbrBytes) : void
+ SPI_writeDataRegister_2(uint8_t clkAddr, uint8_t nbrBytes) : void
+ CAN_readFrame() : void
+ CAN_writeFrame() : void
+ CAN_dataFrame() : void
+ CAN_configurationFrame() : void
+ CAN_broadcastFrame() : void
+ CAN_resetPositionFrame() : void
+ CAN_readDataBytes() : void
+ CAN_readConfigBytes() : void
+ CAN_writeDataRegister(uint8_t clkAddr, uint8_t nbrBytes) : void
+ CAN_writeDataRegister_0(uint8_t clkAddr, uint8_t nbrBytes) : void
+ CAN_writeDataRegister_1(uint8_t clkAddr, uint8_t nbrBytes) : void
+ CAN_writeDataRegister_2(uint8_t clkAddr, uint8_t nbrBytes) : void
+ _evSpiIrq : evSpiIrq
+ _evCanIrq : evCanIrq
+ _evFlagTrigger : evFlagTrigger
+ _evGoToZero : evGoToZero
+ _evDone : evDone
+ _evNullTransition : evNullTransition
- buffer_SPI_rx[] : uint8_t
- buffer_CAN_rx[] : uint8_t
- TxMailBox : uint32_t
- goToZero : bool
- myAddress : uint8_t
- nbrWatchPointer : uint8_t
- statusBytes : uint8_t
- startTime : uint8_t
- stopTime : uint8_t
# _currentState : eMainState
# _oldState : eMainState

+ Clock()
+ ~Clock()
+ initialize(bool nbrWatchPtr) : void
+ getWatchPointer(int index) : WatchPointer*
+ getNbrWatchPointer() : uint8_t
