GeraciGregory/HypnosiaController/Documentation/Altium/HYPNOSIA_controller_V1.pdf

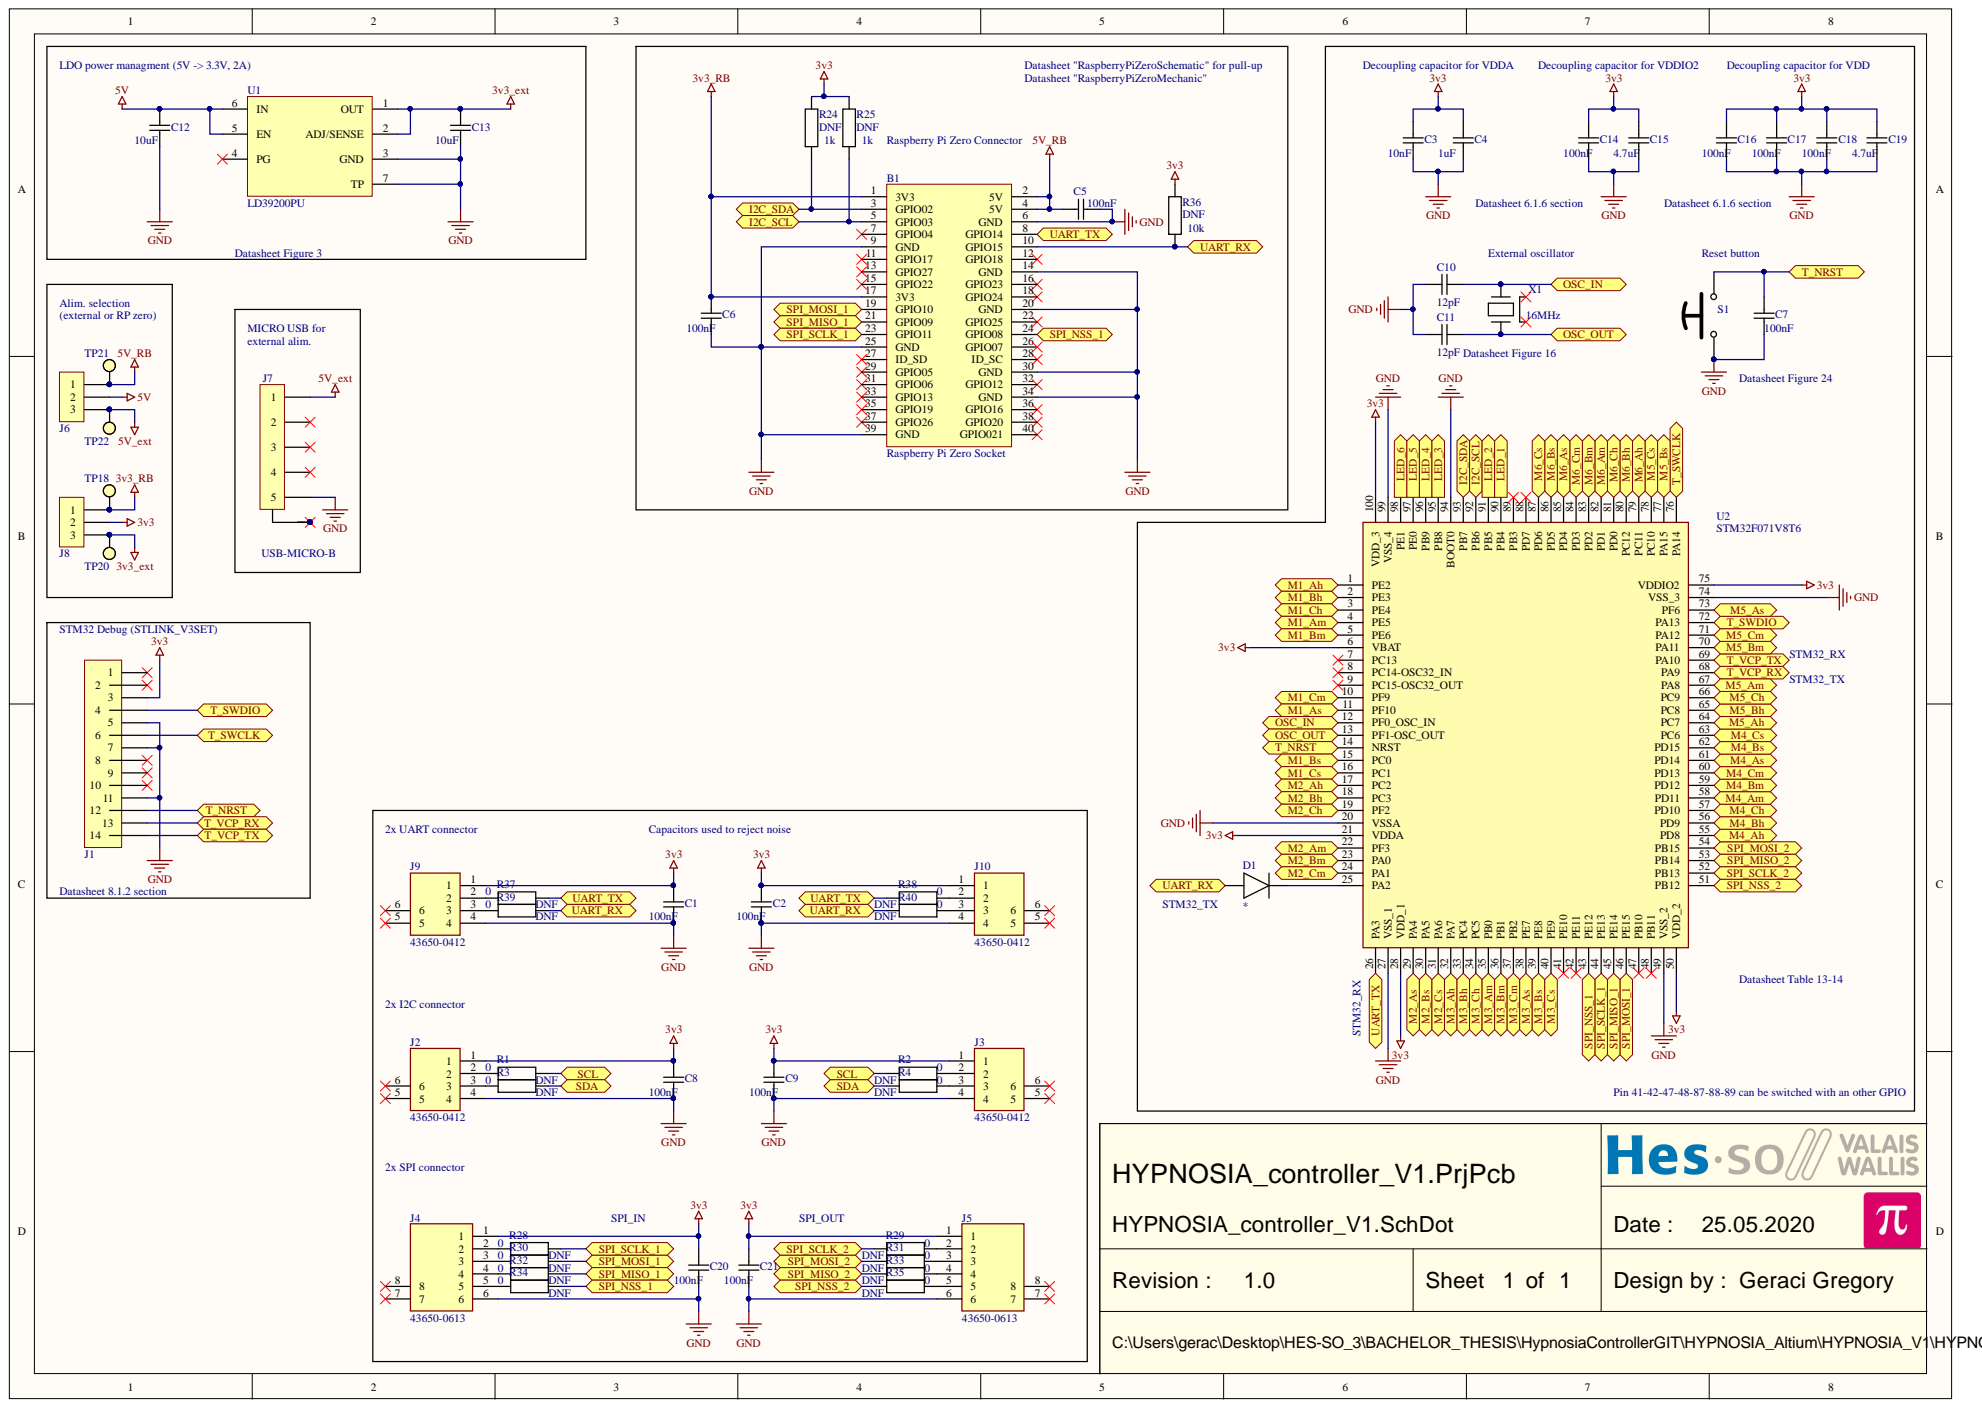
[picture p27: page 1]

Datasheet "RaspberryPiZeroSchematic" for pull-up
Datasheet "RaspberryPiZeroMechanic"

Decoupling capacitor for VDD

Alim. selection
(external or RP zero)

Raspberry Pi Zero Socket

Capacitors used to reject noise

Pin 41-42-47-48-87-88-89 can be switched with an other GPIO

C:\Users\gerac\Desktop\HES-SO_3\BACHELOR_THESIS\HypnosiaControllerGIT\HYPNOSIA_Altium\HYPNOSIA_V1\HYPNOSIA_controller_V1.SchDot

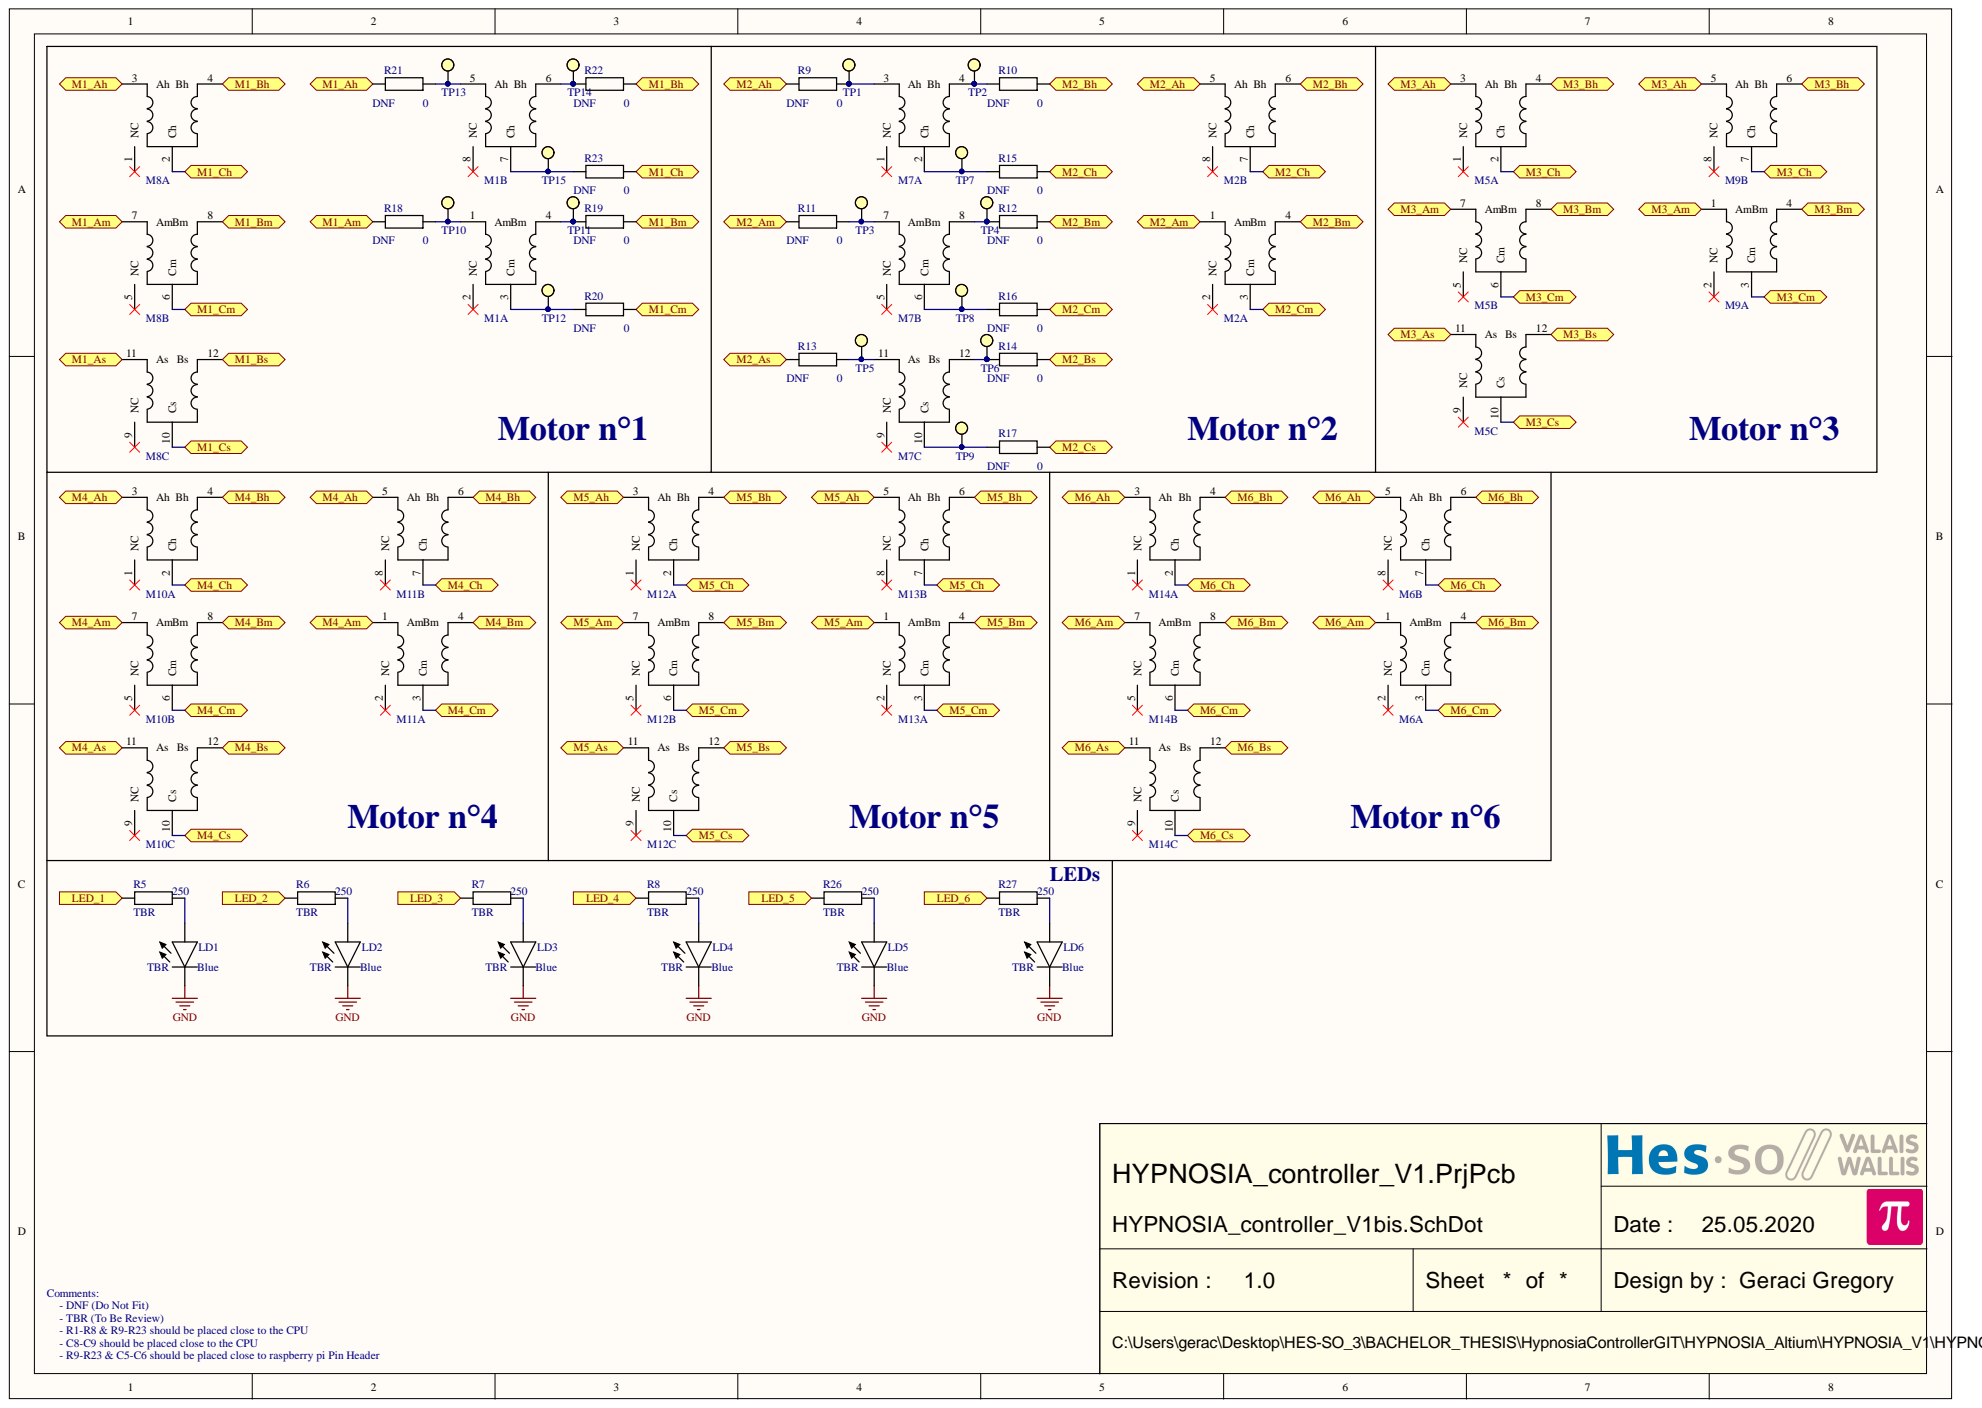
[picture p28: page 2]

HYPNOSIA_controller_V1.PrjPcb HYPNOSIA_controller_V1bis.SchDot

Revision : 1.0 | Sheet * of * | Design by : Geraci Gregory

Comments:
- DNF (Do Not Fit)
- TBR (To Be Review)
- R1-R8 & R9-R23 should be placed close to the CPU
- C8-C9 should be placed close to the CPU
- R9-R23 & C5-C6 should be placed close to raspberry pi Pin Header

C:\Users\gerac\Desktop\HES-SO_3\BACHELOR_THESIS\HypnosiaControllerGIT\HYPNOSIA_Altium\HYPNOSIA_V1\HYPNOSIA_controller_V1bis.SchDot

# Board Stack Report
