GeraciGregory/HypnosiaController/HYPNOSIA_Altium/HYPNOSIA_V1/HYPNOSIA_controller_V1.pdf

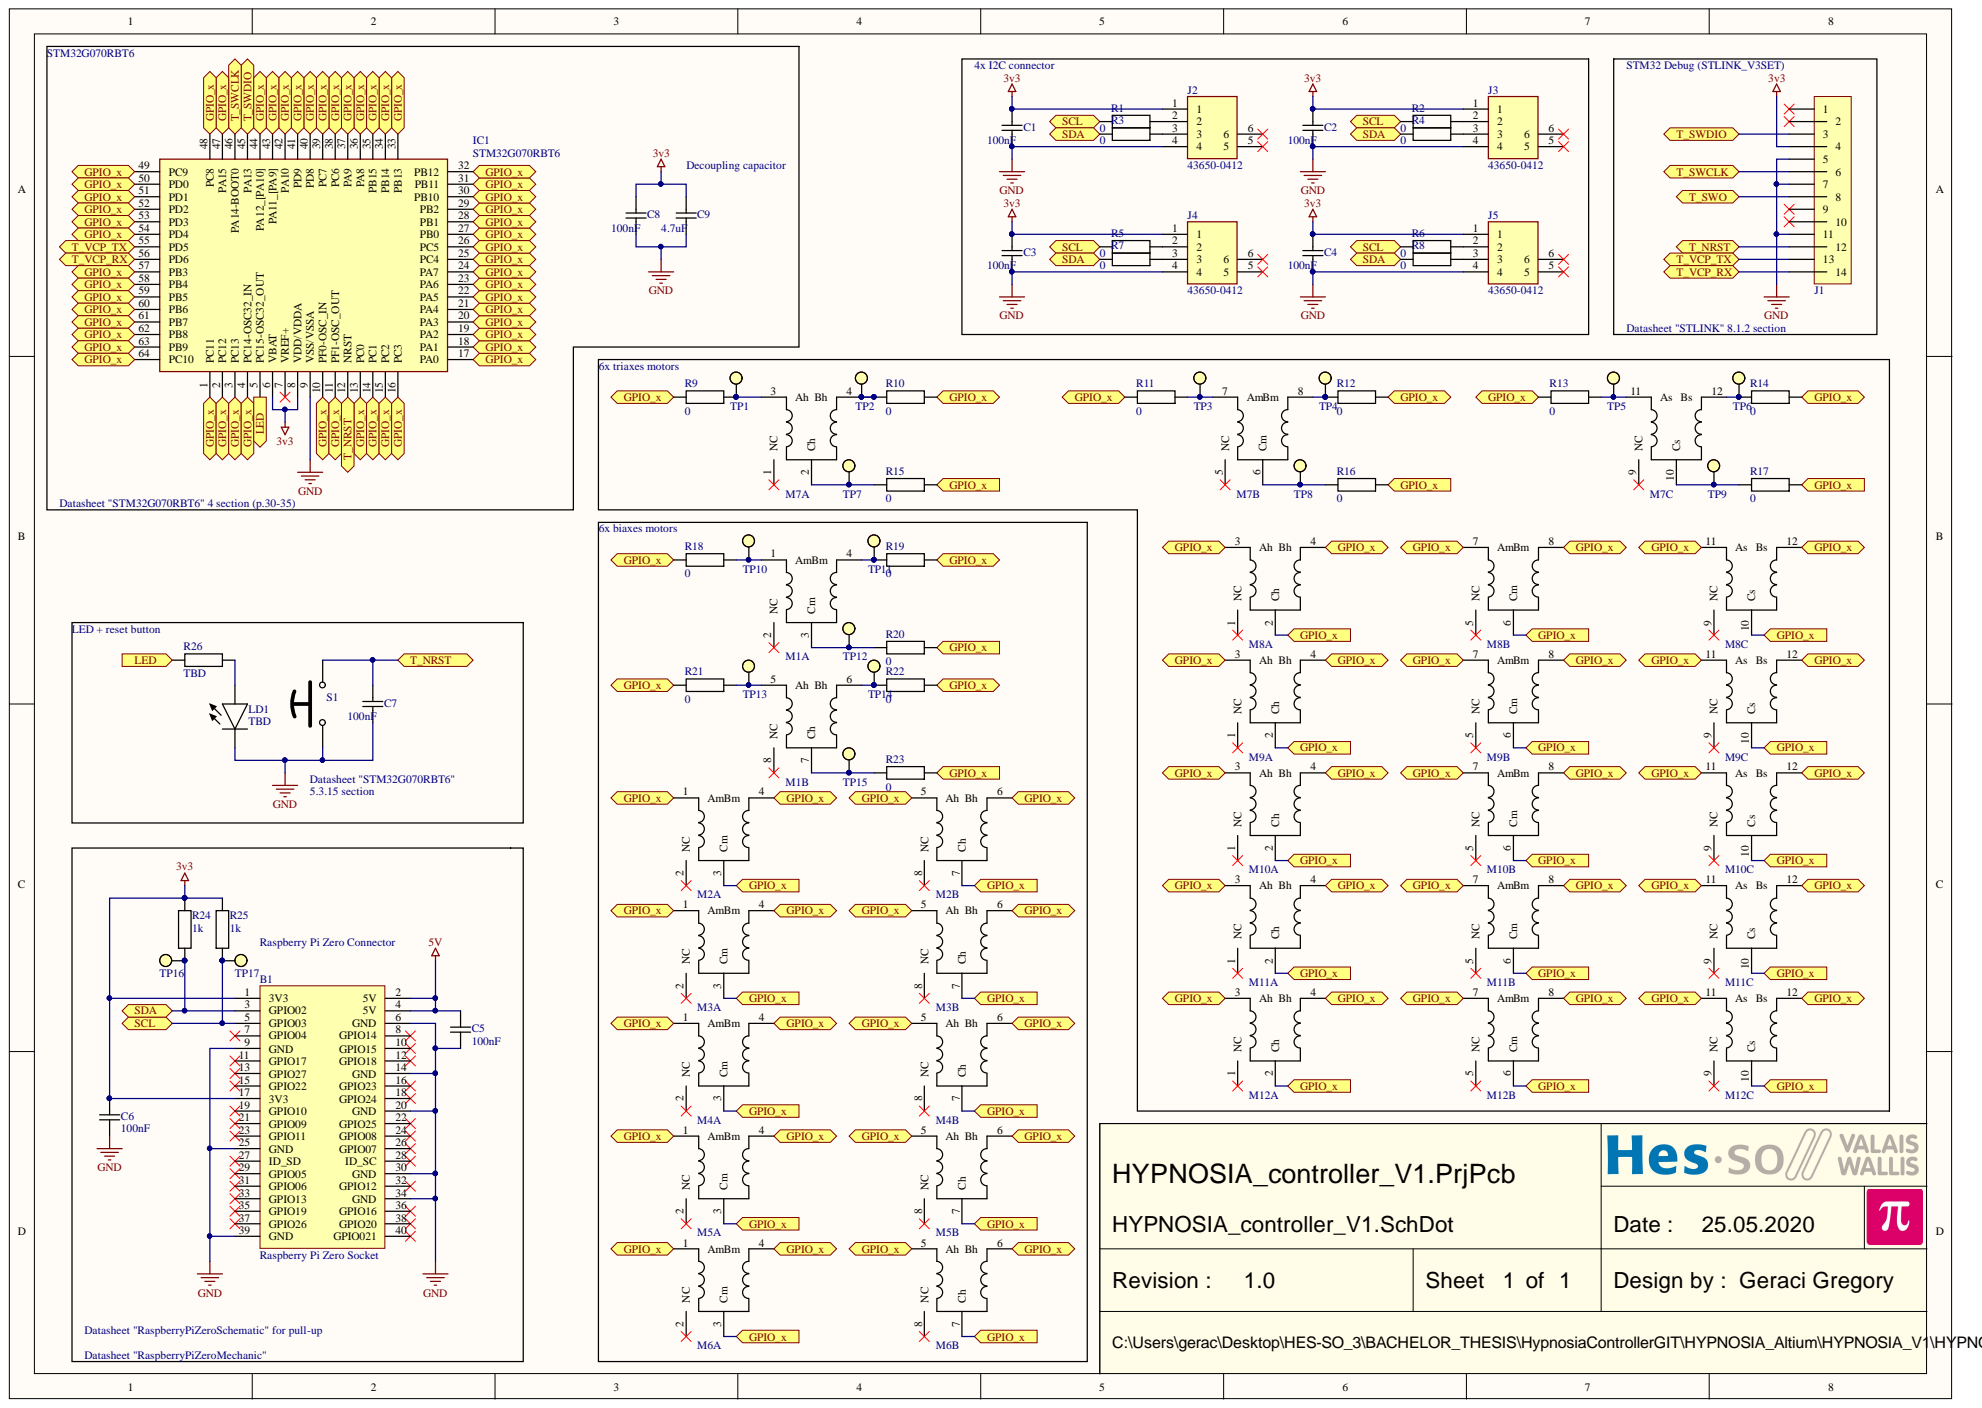
[picture p29: page 1]

Raspberry Pi Zero Socket

Datasheet "RaspberryPiZeroSchematic" for pull-up

C:\Users\gerac\Desktop\HES-SO_3\BACHELOR_THESIS\HypnosiaControllerGIT\HYPNOSIA_Altium\HYPNOSIA_V1\HYPNOSIA_controller_V1.SchDot

# Board Stack Report
