GeraciGregory/HypnosiaController/(list of files, drawings)

Other design files:
HYPNOSIA_Altium/HYPNOSIA_V1/HYPNOSIA_controller_V1.PrjPcb
HYPNOSIA_Altium/HYPNOSIA_V1_CAN/HYPNOSIA_controller_V1.PcbDoc
HYPNOSIA_Altium/HYPNOSIA_V1_CAN/HYPNOSIA_controller_V1.PrjPcb
HYPNOSIA_Altium/HYPNOSIA_V2/HYPNOSIA_V2/HYPNOSIA_controller_V2.PcbDoc
HYPNOSIA_Altium/HYPNOSIA_V2/HYPNOSIA_V2/HYPNOSIA_controller_V2.PrjPcb
HYPNOSIA_Altium/HYPNOSIA_V2/HYPNOSIA_V2/Logos.PcbDoc
