GeraciGregory/HypnosiaController/STM32/STM32HypnosiaController/Core/Src/main.c

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

/* Includes ------------------------------------------------------------------*/
#include "main.h"

/* USER CODE BEGIN Includes */
#include "xf/xf.h"
#include "app/factory.h"
/* USER CODE END Includes */

/* USER CODE BEGIN PTD */
CAN_RxHeaderTypeDef myRxMessage;
CAN_TxHeaderTypeDef myTxMessage;
CAN_FilterTypeDef filterConfig;
/* USER CODE END PTD */

CAN_HandleTypeDef hcan;

SPI_HandleTypeDef hspi1;
DMA_HandleTypeDef hdma_spi1_rx;

TIM_HandleTypeDef htim1;

UART_HandleTypeDef huart1;

/* USER CODE BEGIN PV */
char error[200] = {};
/* USER CODE END PV */

void SystemClock_Config(void);
static void MX_GPIO_Init(void);
static void MX_DMA_Init(void);
static void MX_CAN_Init(void);
static void MX_SPI1_Init(void);
static void MX_USART1_UART_Init(void);
static void MX_TIM1_Init(void);
/**
  * @brief  The application entry point.
  * @retval int
  */
int main(void)
{
  /* MCU Configuration--------------------------------------------------------*/

  /* Reset of all peripherals, Initializes the Flash interface and the Systick. */
  HAL_Init();

  /* Configure the system clock */
  SystemClock_Config();

  /* Initialize all configured peripherals */
  MX_GPIO_Init();
  MX_DMA_Init();
  MX_CAN_Init();
  MX_SPI1_Init();
  MX_USART1_UART_Init();
  MX_TIM1_Init();
  /* USER CODE BEGIN 2 */
  //Filter configuration used for the CAN
  filterConfig.FilterFIFOAssignment = CAN_FILTER_FIFO0;
  filterConfig.FilterIdHigh = 14;
  filterConfig.FilterIdLow = 0;
  filterConfig.FilterMaskIdHigh = 0;
  filterConfig.FilterMaskIdLow = 0;
  filterConfig.FilterScale = CAN_FILTERSCALE_32BIT;
  filterConfig.FilterActivation = ENABLE;
  if(HAL_CAN_ConfigFilter(&hcan, &filterConfig) != HAL_OK)							//Check CAN filter
  {
	  Error_Handler();
  }
  if(HAL_CAN_Start(&hcan) != HAL_OK)  												//Start CAN
  {
	  Error_Handler();
  }
  if(HAL_CAN_ActivateNotification(&hcan, CAN_IT_RX_FIFO0_MSG_PENDING) != HAL_OK)	//Enable CAN interrupt
  {
	  Error_Handler();
  }


  XF_initialize(10);		//Initialize XF
  Factory_initialize();		//Initialize the system
  Factory_build();			//Start behavior of the system
  XF_exec();				//Execute XF
  /* USER CODE END 2 */

  /* Infinite loop */
  /* USER CODE BEGIN WHILE */
  while (1)
  {
    /* USER CODE END WHILE */

    /* USER CODE BEGIN 3 */
  }
  /* USER CODE END 3 */
}

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
