GeraciGregory/HypnosiaController/STM32/STM32HypnosiaController/Core/Inc/main.h

#define SW_0_Pin GPIO_PIN_2
#define SW_0_GPIO_Port GPIOE
#define SW_1_Pin GPIO_PIN_3
#define SW_1_GPIO_Port GPIOE
#define SW_2_Pin GPIO_PIN_4
#define SW_2_GPIO_Port GPIOE
#define SW_3_Pin GPIO_PIN_5
#define SW_3_GPIO_Port GPIOE
#define SW_4_Pin GPIO_PIN_6
#define SW_4_GPIO_Port GPIOE
#define LED_1_Pin GPIO_PIN_10
#define LED_1_GPIO_Port GPIOF
#define M5_Am_Pin GPIO_PIN_2
#define M5_Am_GPIO_Port GPIOF
#define M5_Bm_Pin GPIO_PIN_3
#define M5_Bm_GPIO_Port GPIOF
#define M5_Cm_Pin GPIO_PIN_0
#define M5_Cm_GPIO_Port GPIOA
#define M5_Ah_Pin GPIO_PIN_1
#define M5_Ah_GPIO_Port GPIOA
#define M5_Bh_Pin GPIO_PIN_2
#define M5_Bh_GPIO_Port GPIOA
#define M5_Ch_Pin GPIO_PIN_3
#define M5_Ch_GPIO_Port GPIOA
#define M4_Am_Pin GPIO_PIN_2
#define M4_Am_GPIO_Port GPIOB
#define M4_Bm_Pin GPIO_PIN_7
#define M4_Bm_GPIO_Port GPIOE
#define M4_Cm_Pin GPIO_PIN_8
#define M4_Cm_GPIO_Port GPIOE
#define M4_Ah_Pin GPIO_PIN_9
#define M4_Ah_GPIO_Port GPIOE
#define M4_Bh_Pin GPIO_PIN_10
#define M4_Bh_GPIO_Port GPIOE
#define M4_Ch_Pin GPIO_PIN_11
#define M4_Ch_GPIO_Port GPIOE
#define M1_Am_Pin GPIO_PIN_12
#define M1_Am_GPIO_Port GPIOE
#define M1_Bm_Pin GPIO_PIN_13
#define M1_Bm_GPIO_Port GPIOE
#define M1_Cm_Pin GPIO_PIN_14
#define M1_Cm_GPIO_Port GPIOE
#define M1_Ah_Pin GPIO_PIN_15
#define M1_Ah_GPIO_Port GPIOE
#define M1_Bh_Pin GPIO_PIN_10
#define M1_Bh_GPIO_Port GPIOB
#define M1_Ch_Pin GPIO_PIN_11
#define M1_Ch_GPIO_Port GPIOB
#define STBY_Pin GPIO_PIN_12
#define STBY_GPIO_Port GPIOB
#define M2_Am_Pin GPIO_PIN_13
#define M2_Am_GPIO_Port GPIOB
#define M2_Bm_Pin GPIO_PIN_14
#define M2_Bm_GPIO_Port GPIOB
#define M2_Cm_Pin GPIO_PIN_15
#define M2_Cm_GPIO_Port GPIOB
#define M2_Ah_Pin GPIO_PIN_8
#define M2_Ah_GPIO_Port GPIOD
#define M2_Bh_Pin GPIO_PIN_9
#define M2_Bh_GPIO_Port GPIOD
#define M2_Ch_Pin GPIO_PIN_10
#define M2_Ch_GPIO_Port GPIOD
#define M3_Am_Pin GPIO_PIN_15
#define M3_Am_GPIO_Port GPIOA
#define M3_Bm_Pin GPIO_PIN_10
#define M3_Bm_GPIO_Port GPIOC
#define M3_Cm_Pin GPIO_PIN_11
#define M3_Cm_GPIO_Port GPIOC
#define M3_Ah_Pin GPIO_PIN_12
#define M3_Ah_GPIO_Port GPIOC
#define M3_Bh_Pin GPIO_PIN_0
#define M3_Bh_GPIO_Port GPIOD
#define M3_Ch_Pin GPIO_PIN_1
#define M3_Ch_GPIO_Port GPIOD
#define TP8_Pin GPIO_PIN_3
#define TP8_GPIO_Port GPIOD
#define TP7_Pin GPIO_PIN_4
#define TP7_GPIO_Port GPIOD
#define TP6_Pin GPIO_PIN_5
#define TP6_GPIO_Port GPIOD
#define TP5_Pin GPIO_PIN_6
#define TP5_GPIO_Port GPIOD
#define TP4_Pin GPIO_PIN_7
#define TP4_GPIO_Port GPIOD
#define TP3_Pin GPIO_PIN_3
#define TP3_GPIO_Port GPIOB
#define TP2_Pin GPIO_PIN_4
#define TP2_GPIO_Port GPIOB
#define TP1_Pin GPIO_PIN_5
#define TP1_GPIO_Port GPIOB
#define M6_Am_Pin GPIO_PIN_6
#define M6_Am_GPIO_Port GPIOB
#define M6_Bm_Pin GPIO_PIN_7
#define M6_Bm_GPIO_Port GPIOB
#define M6_Cm_Pin GPIO_PIN_8
#define M6_Cm_GPIO_Port GPIOB
#define M6_Ah_Pin GPIO_PIN_9
#define M6_Ah_GPIO_Port GPIOB
#define M6_Bh_Pin GPIO_PIN_0
#define M6_Bh_GPIO_Port GPIOE
#define M6_Ch_Pin GPIO_PIN_1
#define M6_Ch_GPIO_Port GPIOE
