GeraciGregory/HypnosiaController/STM32/src/event/evClockwise.h

#ifndef EVCLOCKWISE_H_
#define EVCLOCKWISE_H_

#include "EventsID.h"
#include "xf/customevent.h"

class evClockwise : public XFCustomEvent
{
public:
	evClockwise();
	~evClockwise();
};

#endif /* EVCLOCKWISE_H_ */
