GeraciGregory/HypnosiaController/STM32/src/event/evCounterClockwise.cpp

#include "evCounterClockwise.h"

evCounterClockwise::evCounterClockwise() :
	XFCustomEvent(EventsID::evCounterClockwiseId)
{
	//setDeleteAfterConsume(false);
}

evCounterClockwise::~evCounterClockwise()
{}
