GeraciGregory/HypnosiaController/STM32/src/event/evCounterClockwise.h

#ifndef EVCOUNTERCLOCKWISE_H_
#define EVCOUNTERCLOCKWISE_H_

#include "EventsID.h"
#include "xf/customevent.h"

class evCounterClockwise : public XFCustomEvent
{
public:
	evCounterClockwise();
	~evCounterClockwise();
};

#endif /* EVCOUNTERCLOCKWISE_H_ */
