GeraciGregory/HypnosiaController/STM32/src/event/evGoToZero.h

#ifndef EVGOTOZERO_H_
#define EVGOTOZERO_H_

#include "EventsID.h"
#include "xf/customevent.h"

class evGoToZero : public XFCustomEvent
{
public:
	evGoToZero();
	~evGoToZero();
};

#endif /* EVGOTOZERO_H_ */
