GeraciGregory/HypnosiaController/STM32/src/event/evTimeTrigger.h

#ifndef EVTIMETRIGGER_H_
#define EVTIMETRIGGER_H_

#include "EventsID.h"
#include "xf/customevent.h"

class evTimeTrigger : public XFCustomEvent
{
public:
	evTimeTrigger();
	~evTimeTrigger();
};

#endif /* EVTIMETRIGGER_H_ */
