GeraciGregory/HypnosiaController/STM32/src/app/factory.h

#ifndef APP_FACTORY_H
#define APP_FACTORY_H

//
// What is seen only by the C++ compiler
//
#ifdef __cplusplus

#include "main.h"
#include "Controller.h"

/**
 * @brief Factory creating all objects/components and relations between them.
 */
class Factory
{
public:
    Factory();                          ///< Constructor

    static void initialize();           ///< Initializes the factory
    static void build();                ///< Creates components and initializes relations
};

#endif // __cplusplus

//
// What is seen by the C and C++ compiler
//
#ifdef __cplusplus
extern "C" {
#endif // __cplusplus

void Factory_initialize();
void Factory_build();

#ifdef __cplusplus
}
#endif // __cplusplus
#endif // APP_FACTORY_H
