GeraciGregory/HypnosiaController/(commit log)

2020-05-27 Altium Schematic & Datasheets
2020-05-27 Altium project
    [HYPNOSIA_controller_V1.PcbDoc, HYPNOSIA_controller_V1.PrjPcb]
2020-05-28 Altium schematic updated
2020-06-03 Schematic update with new STM32
    [HYPNOSIA_controller_V1.PrjPcb]
2020-06-03 Schematic pdf updated
    [HYPNOSIA_controller_V1.PrjPcb]
2020-06-04 Schematic updated with CAN protocol
    [HYPNOSIA_controller_V1.PcbDoc, HYPNOSIA_controller_V1.PrjPcb]
2020-06-05 Schematic updated bis with CAN protocol
2020-06-08 RaspberryPiZero first boot
2020-06-13 RaspberryPi PC validation SPI frame
2020-06-15 RaspberryPi modif
2020-06-18 Raspberry V1.0 for test updated
2020-06-18 Altium (schematique & routing) V1.0
    [HYPNOSIA_controller_V1.GBL, HYPNOSIA_controller_V1.GBO, HYPNOSIA_controller_V1.GBP, HYPNOSIA_controller_V1.GBS, HYPNOSIA_controller_V1.GTL, HYPNOSIA_controller_V1.GTO, HYPNOSIA_controller_V1.GTP, HYPNOSIA_controller_V1.GTS]
2020-06-30 LEDs, DIP switchs, power, SPI ok
2020-07-03 Final Altium V1
    [HYPNOSIA_controller_V1.PrjPcb]
2020-07-06 Schematic Altium V2.0 updated
    [HYPNOSIA_controller_V2.PrjPcb, Logos.PcbDoc]
2020-07-06 SPI & CAN code ok
2020-07-08 Schematic Altium V2
    [HYPNOSIA_controller_V2.GBL, HYPNOSIA_controller_V2.GBO, HYPNOSIA_controller_V2.GBP, HYPNOSIA_controller_V2.GBS, HYPNOSIA_controller_V2.GTL, HYPNOSIA_controller_V2.GTO, HYPNOSIA_controller_V2.GTP, HYPNOSIA_controller_V2.GTS]
2020-07-08 Box for V2 6x14
    [Assembly1.0001.iam, HYPNOSIA_6x14.0005.iam, HYPNOSIA_6x14.iam, HYPNOSIA_controller_V2.step, back_Box.0007.ipt, back_Box.0009.ipt, back_Box.ipt, front_Box.0007.ipt]
2020-07-14 Box V2.0 6x14 final
    [HYPNOSIA_6x14.0005.iam, HYPNOSIA_6x14.0008.iam, HYPNOSIA_6x14.iam, back_Box.0007.ipt, back_Box.0009.ipt, back_Box.0014.ipt, back_Box.ipt, front_Box.0007.ipt]
2020-07-16 Altium file (also for CNC)
    [Assembly1.0001.iam, HYPNOSIA_6x14.0008.iam, HYPNOSIA_controller_V2.step, back_Box.0014.ipt, back_Box.dxf, back_Box.ipt, front_Box.0010.ipt, front_Box.dxf]
2020-07-30 Inventor box + support
    [HYPNOSIA_controller_V2.step, support.0006.ipt, support.ipt]
2020-07-30 Improved Accuracy (Hardfault handler problem not fixed)
    [Clock.cpp, Clock.h, Controller.cpp, Controller.h, WatchPointer.cpp, WatchPointer.h]
2020-08-14 STM32 Code commented
2020-08-14 Box V2.0, final
    [HYPNOSIA_6x14.0009.iam, HYPNOSIA_6x14.iam, back_Box.0016.ipt, back_Box.ipt, front_Box.0012.ipt, front_Box.ipt, support.0006.ipt, support.0007.ipt]
2020-08-17 Planning added
    [ganttChart.xlsx, ganttChart_bis.xlsx]
